codeempereor/XY-Vision-Picker/02_Hardware/05_实物照片/联调实拍/4a7bcef3391a2931d7f020fb1421db3a.jpg

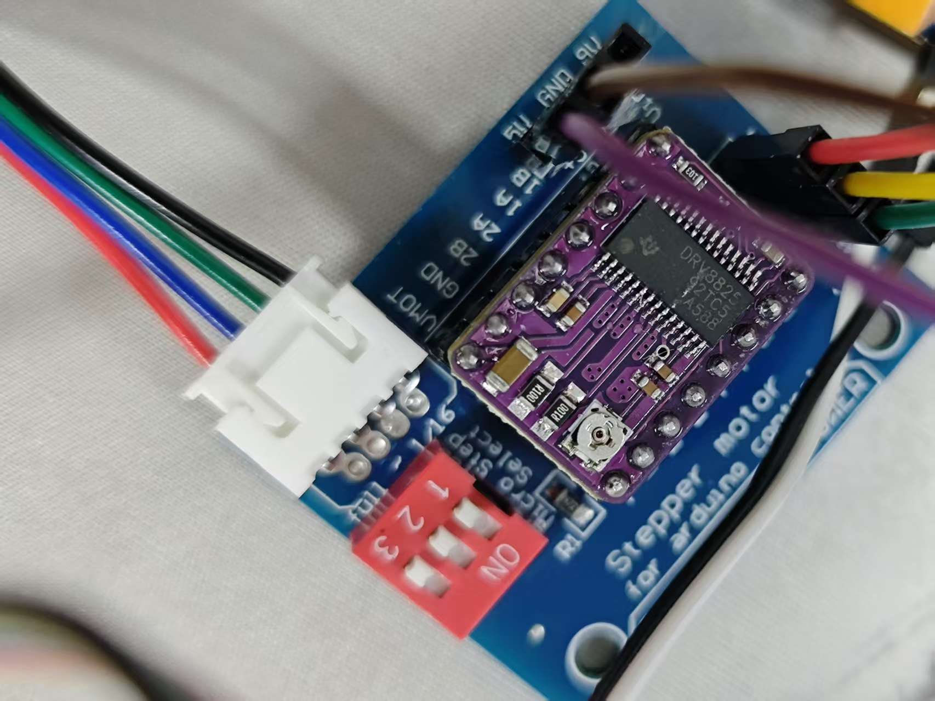
02_Hardware/05_实物照片/联调实拍/4a7bcef3391a2931d7f020fb1421db3a.jpg
