codeempereor/XY-Vision-Picker/02_Hardware/04_接线图/主板安装固定示例 (2).png

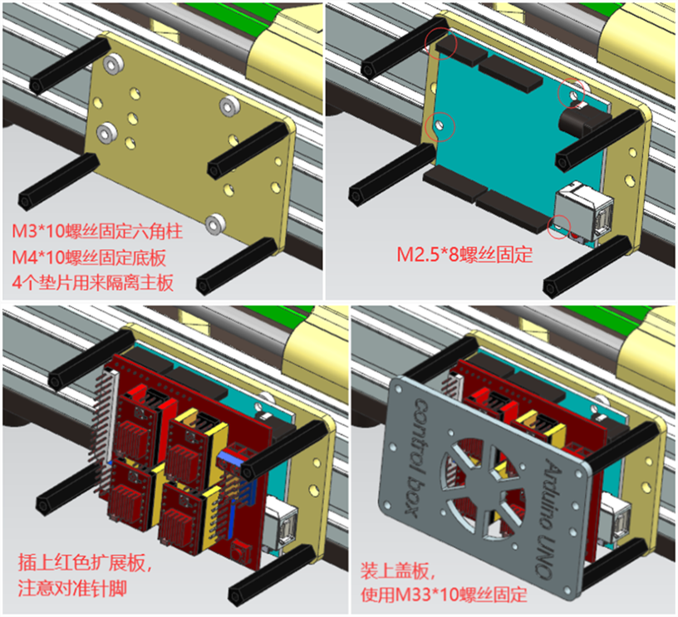
02_Hardware/04_接线图/主板安装固定示例 (2).png
