codeempereor/XY-Vision-Picker/02_Hardware/05_实物照片/README.md

# 实物照片

本项目硬件实物照片档案。

## 目录

| 位置 | 内容 |
|---|---|
| `滑台实物图_01~04.jpg` | CoreXY 滑台整机实拍 |
| `07_开发板实物与标注.bmp` | GEC-M4 开发板引脚标注图（原件来自 D 盘开发板资料包） |
| `08_JLink与开发板的连接.bmp` | J-Link 与开发板连接示意 |
| `联调实拍/` | 2026-10 联调期间实拍：板卡引脚标识、驱动板-电机接线、限位开关、电源模块、上位机界面等（哈希名原样保留） |

## 实物模块照片（按内容命名）

| 文件 | 实物 |
|---|---|
| `联调实拍/电源模块_24V开关电源.jpg` | 24V 开关电源模块（鳄鱼夹接线调试场景） |
| `联调实拍/步进电机_42电机与联轴器滑台.jpg` | 42 步进电机 + 联轴器 + 铝型材滑台 |
| `联调实拍/驱动板_HW434_A4988扩展板.jpg` | HW-434 扩展板 + A4988（含 Micro Step 拨码、电流电位器） |
| `联调实拍/ST-Link_V2调试器.jpg` | ST-LINK V2 下载调试器 |
| `联调实拍/USB转CAN适配器_UTC-T01.jpg` | USB 转 CAN 适配器（UTC-T01：CANH/CANL/GND + 120R 终端开关） |
