codeempereor/XY-Vision-Picker/01_Docs/03_参考文献/README.md

# 参考文献与参考资料索引

本项目引用/参考的第三方资料统一存放在 `06_Resources/`，本目录仅做索引，不重复存放原件。

## 资料分区

| 分区 | 内容 |
|---|---|
| `06_Resources/corexy XY滑台资料/` | CoreXY 滑台框架/安装/接线资料、42 步进电机、A4988 电流调节、安装视频（含 03.滑块安装、10.同步带同步轮安装 等） |
| `06_Resources/PCAN/` | USB 转 CAN 全套：上位机软件（pcanview/TSMaster/cangaroo）、驱动（win/linux）、二次开发 PCAN-Basic、原理图、固件烧录工具、USB 转 CAN 使用说明书 |
| `06_Resources/STM32F407ZET6/` | STM32F407 数据手册、F4 中文参考手册、Cortex-M4 内核编程手册、标准外设库手册、GEC-M4 原理图 |
| `06_Resources/YX64074-OV2640摄像头红版-190518/` | OV2640 摄像头模块原理图、参考资料、配套软件（串口摄像头调试） |

## 关键文档（按需查阅）

| 文档 | 位置 |
|---|---|
| STM32F4xx 中文参考手册 | `06_Resources/STM32F407ZET6/STM32F4xx中文参考手册.pdf` |
| GEC-M4 原理图 | `06_Resources/STM32F407ZET6/GEC-M4原理图2016-07-29.pdf` |
| USB 转 CAN 使用说明书 | `06_Resources/PCAN/USB转CAN使用说明书.pdf` |
| 滑台主板接线图 | `06_Resources/corexy XY滑台资料/步骤3.corexy主板安装接线图.doc` |

> 注：`01_Docs/02_开发文档/` 中的各模块开发文档亦引用了上述资料，正文中出现的事实以开发文档与实物为准。
