codeempereor/XY-Vision-Picker/06_Resources/corexy XY滑台资料/CH340G_USB转TTL驱动程序/README.txt

1. Install the program.
2. Copy Loader to the program directory - something like C:\Program Files\Simplify 3D 3.0.2\
3. Change the destkop shortcut to point to the loader. 
4. Happy printing! :)

I compiled the program with visual studio so you may need to download the Visual C++ redistributable. And yes it is because i'm lazy! :P

By the way, sometimes the Loader may be too slow and fail to initiate the program. In that case just execute it again. :)
Tested under windows 10
