codeempereor/XY-Vision-Picker/06_Resources/PCAN/驱动/linux/操作说明.txt

ubuntu系统上使用

(1) 需要确认安装好下面的相关库：

	# sudo apt-get install libpopt-dev
	# sudo apt install make
	# sudo apt install make-guile
	# sudo apt install gcc
	# sudo apt install g++
	# sudo apt install libpopt-dev

(2) 安装pcan驱动：

	# tar xvf peak-linux-driver-8.15.2.tar.gz
	# cd peak-linux-driver-8.15.2/
	# make clean
	# make
	# sudo make install 

	# pcaninfo		（接上板子之后，输入这个命令可以查看到pcan驱动和板子的信息）

boardcon@ubuntu20:~/opt/peak-linux-driver-8.15.2$ pcaninfo
PCAN driver version: 8.15.2
PCAN-Basic version: 4.6.2.36

  * pcanusb32: "PCAN_USBBUS1" (0x051), PCAN-USB #1, devid=0x00 (/sys/class/pcan/pcanusb32)

(3) 安装 pcanview:

	# wget -q http://www.peak-system.com/debian/dists/`lsb_release -cs`/peak-system.list -O- | sudo tee /etc/apt/sources.list.d/peak-system.list
	# wget -q http://www.peak-system.com/debian/dists/wheezy/peak-system.list -O- | sudo tee /etc/apt/sources.list.d/peak-system.list
	# wget -q http://www.peak-system.com/debian/peak-system-public-key.asc -O- | sudo apt-key add -
	# sudo apt-get update
	# sudo apt-get install pcanview-ncurses

	执行完上面的命令之后，pcanview 就安装成功了，可以查看到： 

	# ls /usr/bin/pcanview	

	# pcanview	(运行pcanview应用，设置好波特率后就可以收发数据了)

其他参考安装pcanview:	（测试未通过，安装完之后，执行 pcanview 命令提示没有这个目录或文件）

	#wget https://www.peak-system.com/debian/dists/trusty/non-free/binary-i386/pcanview-ncurses_0.8.9-0_i386.deb
	#sudo dpkg -i pcanview-ncurses_0.8.9-0_i386.deb

	#wget https://www.peak-system.com/debian/dists/trusty/non-free/binary-i386/pcanview-ncurses_0.9.2-0_i386.deb
	#sudo dpkg -i pcanview-ncurses_0.9.2-0_i386.deb
