codeempereor/XY-Vision-Picker/01_Docs/02_开发文档/01_视觉识别模块开发文档.docx

视觉识别模块开发文档

K210 + OV2640 颜色识别与坐标输出

XY_Vision_Picker 项目

版本：v1.0 ｜ 日期：2026-09-23 ｜ 状态：开发指导

1. 模块概述

1.1 职责

本模块负责采集工作台面图像，通过颜色分割识别目标色块，输出其像素质心坐标给 STM32 主控。本模块不做运动决策，只做视觉检测与坐标输出。

1.2 性能指标

表 1-1 视觉模块性能指标

指标 | 目标值
分辨率 | QVGA 320×240，RGB565
识别帧率 | ≥ 10 fps（周期 80 ms）
坐标输出 | 像素质心 (cx, cy)，单位像素
识别成功率 | 标准色块 ≥ 95%（实时光照下）
通信接口 | UART 115200-8-N-1
未识别输出 | $0,0,0\n

1.3 硬件清单

表 1-2 视觉模块硬件清单

# | 物料 | 型号/规格 | 数量 | 备注

1 | 视觉主控 | K210 开发板（Maix Bit） | 1 | Type-C 供电
2 | 摄像头模块 | 正点原子 ATK-OV2640 红版 V1.2 | 1 | 2×9 排针
3 | 连接线 | 杜邦线公对公 15 根 | 1 排 | 飞线用
4 | 限流电阻 | 1 kΩ 0805 或直插 | 8 个 | D0~D7 数据线各串一个
5 | 遮光罩 | 黑色卡纸或 3D 打印 | 1 | 固定在镜头周围

2. 硬件接线

2.1 OV2640 模块引脚定义

ATK-OV2640 模块为 2×9 排针（2.54 mm 间距），共 18 个引脚，其中 15 个有效。模块自带 12 MHz 有源晶振和 1.3V/2.8V LDO，外部仅需 3.3V 供电。

表 2-1 OV2640 模块引脚定义

引脚号 | 名称 | 方向 | 说明
1 | GND | — | 地线
2 | VCC3.3 | IN | 3.3V 电源
3 | OV_SCL | IN | SCCB 时钟（类 IIC）
4 | OV_VSYNC | OUT | 帧同步
5 | OV_SDA | IN/OUT | SCCB 数据
6 | OV_HREF | OUT | 行参考
7 | OV_D0 | OUT | 数据线 bit0
8 | OV_RESET | IN | 复位（低有效）
9~14 | OV_D1~D6 | OUT | 数据线 bit1~bit6
15 | OV_PCLK | OUT | 像素时钟
16 | OV_D7 | OUT | 数据线 bit7
17 | OV_PWDN | IN | 掉电使能（高有效）
18 | NC | — | 不接

2.2 K210 飞线对照表

K210 开发板（Maix Bit）的 DVP 摄像头接口与 OV2640 模块引脚对照如下。D0~D7 数据线各串 1 kΩ 电阻限流，其余直连。

表 2-2 OV2640 ↔ K210 飞线对照表

OV2640 引脚 | K210 引脚 | 备注
GND | GND | 共地
VCC3.3 | 3.3V | 模块供电
OV_SCL (SIO_C) | IO_SCL (GPIOS)
OV_SDA (SIO_D) | IO_SDA (GPIOS)
OV_VSYNC | IO7
OV_HREF | IO6
OV_PCLK | IO5
OV_D0 | IO8 | 串 1 kΩ
OV_D1 | IO9 | 串 1 kΩ
OV_D2 | IO10 | 串 1 kΩ
OV_D3 | IO11 | 串 1 kΩ
OV_D4 | IO12 | 串 1 kΩ
OV_D5 | IO13 | 串 1 kΩ
OV_D6 | IO14 | 串 1 kΩ
OV_D7 | IO15 | 串 1 kΩ
OV_RESET | 直连 GND（不复位）或 IO 控制
OV_PWDN | 直连 GND（不进掉电）

注意：以上引脚为 Maix Bit 标准 DVP 接口定义，实际以所用 K210 开发板丝印为准。若使用其他 K210 板型，需查该板型的摄像头引脚映射。

3. 开发环境搭建

3.1 软件安装

- 安装 MaixPy IDE（官网下载 Windows 版），用于在线编程和调试；
- K210 开发板用 Type-C 线连 PC，设备管理器看到串口（CH340 或类似）；
- MaixPy IDE 左下角选对应串口，波特率 115200；
- 点连接，运行 `print("hello")` 确认环境通。

3.2 出图验证

连接好 OV2640 后，先运行最小出图代码：

import sensor, time
sensor.reset()
sensor.set_pixformat(sensor.RGB565)
sensor.set_framesize(sensor.QVGA)
sensor.run(1)
while True:
img = sensor.snapshot()
time.sleep_ms(50)

MaixPy IDE 应实时显示摄像头画面。若黑屏：检查排线/飞线方向、3.3V 供电是否接对、PWDN 是否拉低。

4. 软件设计

4.1 主程序结构

import sensor, image, time, gc
from machine import UART

# 初始化串口
uart = UART(UART.UART1, 115200, timeout=1000)

# 初始化摄像头
sensor.reset()
sensor.set_pixformat(sensor.RGB565)
sensor.set_framesize(sensor.QVGA) # 320x240
sensor.run(1)

# LAB 颜色阈值（标定后替换）
RED = (30, 80, 30, 80, -20, 20)

while True:
img = sensor.snapshot()
blobs = img.find_blobs([RED],
pixels_threshold=200,
area_threshold=200,
merge=True)
if blobs:
b = max(blobs, key=lambda x: x.pixels())
cx, cy = b.cx(), b.cy()
uart.write("$%d,%d,1\n" % (cx, cy))
else:
uart.write("$0,0,0\n")
gc.collect()
time.sleep_ms(80)

4.2 阈值标定

LAB 阈值必须在实际工作光照下标定，不能直接用默认值。标定方法：

- 把目标色块放在工作台上，用最终装配的光源照射；
- MaixPy IDE 运行 `img.binary([THRESHOLD])` 观察二值化结果；
- 拖动 L/A/B 上下界滑块，直到目标块完整保留、背景全部变黑；
- 记录三组上下界 (L_min, L_max, A_min, A_max, B_min, B_max)，写入代码；
- 标定后加半透明遮光罩，避免环境光变化导致阈值漂移；
- 多颜色目标时，定义多组阈值数组，由 STM32 通过 color_id 选择。

4.3 串口协议

表 4-1 视觉串口协议

方向 | 格式 | 说明
K210→STM32 | $cx,cy,flag\n | 例：$128,96,1\n（识别到目标）
K210→STM32 | $0,0,0\n | 未识别到目标
STM32→K210 | @STATUS\n | 0=可识别，1=运动中忽略，2=完成

STM32 在运动中回复 @1，K210 收到后仍持续发坐标但 STM32 忽略；抓取完成后 STM32 回复 @2，K210 进入下一周期检测。

5. 开发步骤

表 5-1 视觉模块开发步骤

步骤 | 内容 | 验收标准
1 | 飞线连接 OV2640 到 K210 | MaixPy IDE 能出图，无花屏
2 | 固定摄像头安装位置 | 镜头正对工作台，画面覆盖整个工作区
3 | 实际光照下标定 LAB 阈值 | 目标块二值化完整，背景无残留
4 | 写主循环 find_blobs + 串口发送 | 串口助手看到 $cx,cy,1 实时跟随
5 | 未识别测试：移走色块 | 串口发 $0,0,0\n
6 | 80ms 周期稳定性测试 | 连续 5 分钟无丢帧、无乱码
7 | 加遮光罩，复测阈值 | 不同时间段光照下识别率稳定

6. 调试方法

6.1 常见问题

表 6-1 视觉模块常见问题

现象 | 排查方向
黑屏无图像 | PWDN 拉高？RESET 拉高？3.3V 供电？飞线接反？
花屏/颜色异常 | PCLK 极性？D0~D7 接错位？数据线串电阻过大？
识别时有时无 | 光照变化？阈值太窄？加遮光罩重新标定
串口乱码 | 波特率不一致？TX/RX 接反？未共地？
坐标跳动大 | blob 噪声多？pixels_threshold 调高？merge=True？

6.2 调试工具

- 串口助手：XCOM 或 PuTTY，115200 8-N-1，看 $ 帧格式；
- MaixPy IDE 阈值编辑器：实时调阈值；
- 在代码里加 `img.draw_rectangle(b.rect())` 画框，IDE 里看识别位置。

7. 验收标准

- MaixPy IDE 实时出图，画面清晰；
- 目标色块在工作区任意位置，串口 80ms 内输出正确质心坐标；
- 移走色块，500ms 内输出 $0,0,0；
- 连续运行 30 分钟无死机、无丢帧；
- 实时光照下识别成功率 ≥ 95%。

8. 风险与注意事项

表 8-1 视觉模块风险清单

风险 | 后果 | 对策
飞线接触不良 | 图像闪烁或无图 | 杜邦线插紧，必要时焊接
未加遮光罩 | 阈值随光照漂移 | 必须加遮光罩，固定标定
D0~D7 未串电阻 | 长期可能损 K210 IO | 按设计串 1 kΩ
摄像头安装倾斜 | 仿射标定误差大 | 镜头垂直工作台，用水平尺校准
未识别时未发 $0,0,0 | STM32 卡在旧坐标 | 主循环必须每次都发帧
