codeempereor/XY-Vision-Picker/01_Docs/02_开发文档/02_运动控制模块开发文档.docx

运动控制模块开发文档

STM32 + CoreXY + DRV8825 + MG90S

XY_Vision_Picker 项目

版本：v1.0 ｜ 日期：2026-09-23 ｜ 状态：开发指导

1. 模块概述

1.1 职责

本模块是系统核心，负责接收视觉坐标，完成像素→毫米换算、运动规划、步进脉冲输出、夹爪控制，并通过 CAN 上报状态。同时支持本地 TFT 屏 + 键盘离线操作。

1.2 性能指标

表 1-1 运动模块性能指标

指标 | 目标值
定位精度 | ≤ ±1 mm
最大速度 | 100 mm/s（可参数化）
加减速时间 | 200 ms（S 形）
单轴行程 | X: 200 mm，Y: 150 mm
脉冲当量 | 0.05 mm/脉冲（1/16 细分）
限位响应 | 硬件立即停脉冲，< 1 ms
CAN 上报周期 | 心跳 1 Hz，位置 20 Hz

2. 硬件设计

2.1 电源分配

表 2-1 电源分配表

电源 | 电压 | 负载 | 说明
主电源 | 24V/5A | DRV8825 电机供电 | 滑台电机
舵机电源 | 5V/2A | MG90S 夹爪 | 独立供电，禁止从板载 5V 取
逻辑电源 | 3.3V | STM32、TFT、键盘 | 板载 LDO
CAN 收发器 | 5V | TJA1050 | 与逻辑地共地

关键约束：MG90S 必须独立 5V 供电。舵机堵转瞬间电流可达 1A 以上，从 STM32 板载 5V 取电会拉低电压导致 MCU 复位。

2.2 STM32 引脚分配

表 2-2 STM32F407 引脚分配表

功能 | 引脚 | 外设/说明
X 轴 STEP | PA0 | TIM2_CH1 脉冲输出
X 轴 DIR | PB0 | GPIO 推挽
Y 轴 STEP | PA1 | TIM3_CH1 脉冲输出
Y 轴 DIR | PB1 | GPIO 推挽
舵机 PWM | PA8 | TIM1_CH1，50 Hz
K210 UART_RX | PA10 | USART1_RX
K210 UART_TX | PA9 | USART1_TX
TFT SPI SCK | PA5 | SPI1_SCK
TFT SPI MOSI | PA7 | SPI1_MOSI
TFT CS/DC/RST/BL | PB10/PB11/PB12/PB13 | GPIO
矩阵键盘 R1~R4 | PC0~PC3 | GPIO 输出
矩阵键盘 C1~C4 | PC4~PC7 | GPIO 上拉输入
CAN_RX / CAN_TX | PA11 / PA12 | CAN1 不重映射
限位 X+/X-/Y+/Y- | PB14/PB15/PB16/PB17 | 下拉输入
用户 LED | PC13 | 心跳指示，低电平点亮

2.3 DRV8825 驱动配置

- 细分：MS1/MS2/MS3 全部接 GND → 1/16 细分；
- Vref 计算：Vref = Imax × 0.5（DRV8825 公式）。42 电机额定 1.2A → Vref = 0.6V；
- 调 Vref：上电前先测电机线圈电阻，串万用表测电流，调电位器到目标电流；
- ENABLE：接 GPIO 或直接拉低使能，上电时默认失能避免误动；
- 散热：DRV8825 发热较大，必须贴散热片。

2.4 限位与急停

- 4 个限位开关（X+/X-/Y+/Y-）接 GPIO 下拉输入，触发为高电平；
- 限位中断优先级最高，触发立即关闭定时器脉冲输出；
- 限位触发后通过 CAN 0x301 上报，TFT 显示错误码，需上位机或键盘复位才能继续。

3. CubeMX 配置

3.1 时钟树

- HSE 8MHz 外部晶振 → PLL 倍频 → SYSCLK 168 MHz；
- APB1 定时器时钟 84 MHz，APB1 外设时钟 42 MHz（CAN 用此）；
- APB2 定时器时钟 168 MHz。

3.2 外设配置清单

表 3-1 CubeMX 外设配置

外设 | 参数 | 用途
TIM2 | CH1 PWM，分频 84-1，ARR 动态 | X 轴 STEP 脉冲
TIM3 | CH1 PWM，分频 84-1，ARR 动态 | Y 轴 STEP 脉冲
TIM1 | CH1 PWM，1MHz 计数，ARR=20000 | 舵机 50 Hz
USART1 | 115200 8-N-1，收发中断 | K210 通信
CAN1 | 500 kbps，列表 0 屏蔽位 | 上位机通信
SPI1 | 全双工主，10.5 MHz | TFT 屏
GPIO | PC0~PC7 键盘，PB14~PB17 限位 | 输入输出
FMC/FSMC | 未用

3.3 FreeRTOS 配置

- 系统时钟基准：SysTick 1 kHz；
- 堆大小：128 字；
- 任务数：5 个（见第 4 章）；
- 队列：坐标队列（深度 4）、命令队列（深度 4）；
- 优先级：运动任务 5（最高），通信 4，键盘 3，显示 2，心跳 1。

4. 软件架构

4.1 任务划分

表 4-1 FreeRTOS 任务划分

任务 | 优先级 | 周期/触发 | 栈大小 | 职责
vCommTask | 4 | 事件驱动 | 1024 | UART 收 K210 帧、CAN 收发
vMotionTask | 5 | 事件驱动 | 512 | 坐标→插补→脉冲→舵机
vDisplayTask | 2 | 50 ms | 512 | 刷新 TFT
vKeyTask | 3 | 20 ms | 256 | 矩阵键盘扫描
vHeartbeatTask | 1 | 1 s | 256 | LED 闪烁 + CAN 心跳

4.2 状态机

运动任务内部维护状态机，避免命令竞争：

STATE_IDLE = 0 # 空闲
STATE_HOME = 1 # 回零
STATE_MANUAL = 2 # 手动
STATE_AUTO = 3 # 自动抓取
STATE_GRIPPING = 4 # 抓取中
STATE_DONE = 5 # 完成

状态切换由命令帧（0x201）或事件（到位/限位/错误）触发。运动中收到新坐标入队，当前运动完成后再处理。

5. 运动学算法

5.1 CoreXY 解算

CoreXY 平台两电机转角与滑台位置耦合。设两电机脉冲增量为 dm1、dm2：

dx = (dm1 + dm2) / 2 # 滑台 X 方向脉冲增量
dy = (dm1 - dm2) / 2 # 滑台 Y 方向脉冲增量
dm1 = dx + dy # 电机1脉冲
dm2 = dx - dy # 电机2脉冲

方向判定：上位机或键盘发目标 (tx, ty)，先算位移 (dx_mm, dy_mm)，乘脉冲当量得到脉冲数 (px, py)，再反解为两电机脉冲，分别输出。

5.2 脉冲当量计算

以 GT2 同步带（齿距 2mm）、16 齿同步轮为例：每圈 32mm，1/16 细分下每圈 3200 脉冲，脉冲当量 = 32/3200 = 0.01 mm/脉冲。实际值需实测：手动走 100mm 记录脉冲数，反算脉冲/mm。

5.3 S 形加减速

- 起步段：200ms 内从 0 加速到目标速度，线性插值；
- 匀速段：按目标速度运行；
- 停止段：200ms 内减速到 0；
- 实现方式：定时器 ARR 动态修改，频率随速度变化；
- 低速运行（< 20mm/s）可省略加减速，直接以低速启动。

5.4 直线插补

采用 Bresenham 逐点比较法：以位移较长的轴为主轴，每发一个主轴脉冲，副轴按误差累积决定是否补脉冲。保证两轴同时到位。

6. 视觉-运动学标定

6.1 标定流程

- 滑台回机械零位（X-、Y- 限位触发点）；
- 工作台面放置打印网格标记点（如 (20,20)、(60,60)、(100,100)、(140,100)、(180,20)，单位 mm）；
- 手动移动滑台到每个标记点上方，K210 读取该点像素坐标；
- 最小二乘拟合仿射变换系数 (a,b,c,d,e,f)；
- 系数存入 STM32 内部 Flash 保留扇区（0x0800 FC00）；
- 用 3 个未参与拟合的点验证，误差 ≤ ±1 mm。

6.2 仿射变换模型

mm_x = a * px + b * py + c
mm_y = d * px + e * py + f

采用仿射而非简单比例，补偿摄像头非垂直安装带来的平移、旋转、缩放与切变误差。

6.3 Flash 存储

- 地址：0x0800 FC00（F407 最后一页，2KB）；
- 结构：魔数 0xCA11AB1E + 6 个 float 系数 + CRC；
- 上电读 Flash，魔数不对则用默认值 (1,0,0,0,1,0)，提示重新标定。

7. 开发步骤

表 7-1 运动模块开发步骤

步骤 | 内容 | 验收标准
1 | 单轴点动：X 轴发脉冲走 100mm | 平稳无异响，记录脉冲/mm
2 | Y 轴同上 | 方向正确
3 | CoreXY 解算：双轴走矩形 | 5 圈无丢步、无累计偏差
4 | S 形加减速 | 高速起步不丢步
5 | 舵机 50Hz PWM | 0/90/180° 到位不抖
6 | 4 个限位触发 | 立即停脉冲，发错误码
7 | TFT 显示 + 键盘扫描 | 坐标/状态/计数正确
8 | UART 收 K210 坐标 | TFT 显示毫米坐标
9 | 仿射标定 | 3 验证点误差 ≤ ±1mm
10 | 整链抓取 | 连续 20 次成功率 ≥ 90%

8. 调试方法

8.1 常见问题

表 8-1 运动模块常见问题

现象 | 排查方向
电机不转 | DIR/STEP 接线？Vref 太低？ENABLE 拉高？
丢步 | 速度太快？加减速时间太短？Vref 不足？
方向反 | 电机线反转 180° 或改 DIR 逻辑
XY 颠倒 | CoreXY 解算 dm1/dm2 接反
MCU 复位 | 舵机从板载取电？独立 5V 接了吗？
限位误触发 | 上拉/下拉接反？开关型号？

9. 验收标准

- 单轴手动走 100mm，重复定位误差 ≤ ±0.5mm；
- 矩形轨迹 5 圈无累计偏差；
- 4 个限位触发立即停，无误触发；
- 舵机夹爪开合到位，不抖动；
- 仿射标定误差 ≤ ±1mm；
- 自动抓取连续 20 次成功率 ≥ 90%；
- 连续运行 30 分钟无死机、无丢步、无异常温升。

10. 风险与注意事项

表 10-1 运动模块风险清单

风险 | 后果 | 对策
MG90S 板载取电 | MCU 复位 | 独立 5V 供电
DRV8825 Vref 过高 | 烧电机 | 按 Imax×0.5 计算，串电流表调
未加散热片 | 驱动过热保护 | 必须贴散热片
高速无加减速 | 丢步 | S 形加减速 200ms
限位时序错 | 撞机械 | 上电先测限位逻辑
24V 带电插拔 | 烧驱动 | 断电接线
