codeempereor/XY-Vision-Picker/01_Docs/02_开发文档/03_上位机模块开发文档.docx

上位机模块开发文档

Qt Widgets + QCanBus (peakcan)

XY_Vision_Picker 项目

版本：v1.0 ｜ 日期：2026-09-23 ｜ 状态：开发指导

1. 模块概述

1.1 职责

上位机运行在 PC 上，通过 PEAK 兼容 USB-CAN 适配器与 STM32 通信，负责设备状态监控、运动轨迹绘制、命令下发、参数设置和日志记录。上位机不参与实时闭环，断开不影响 STM32 本地运行。

1.2 性能指标

表 1-1 上位机性能指标

指标 | 目标值
CAN 波特率 | 500 kbps
状态刷新 | 20 Hz（位置帧）
轨迹绘制 | 实时滚动，延迟 < 100ms
命令响应 | 按钮到 STM32 执行 < 50ms
日志格式 | CSV，时间戳+坐标+结果
平台 | Windows 10/11 64位

2. 开发环境

2.1 软件安装

表 2-1 开发环境

软件 | 版本 | 用途
Qt Creator | 5.15 LTS MinGW 64 | IDE
Qt 模块 | SerialBus, Widgets | CAN + UI
QCustomPlot | 2.x | 实时轨迹绘图
PEAK 驱动 | PeakOemDrv.exe | PCAN 适配器驱动
编译器 | MinGW 7.3 64bit | Qt 自带

2.2 工程配置

pro 文件关键配置：

QT += core gui widgets serialbus

SOURCES += main.cpp \
mainwindow.cpp \
candevice.cpp
HEADERS += mainwindow.h \
candevice.h

# QCustomPlot
INCLUDEPATH += $$PWD/qcustomplot
SOURCES += $$PWD/qcustomplot/qcustomplot.cpp
HEADERS += $$PWD/qcustomplot/qcustomplot.h

2.3 PEAK 驱动安装

- 解压 PEAK-System_Driver-Setup.zip，运行 PeakOemDrv.exe；
- 插 PCAN 适配器，设备管理器看到 PEAK USB CAN；
- 拨码开关拨到 120R（启用终端电阻）；
- 用 PcanView.exe 验证：选 500kbps，Connect，能看到设备在线。

3. CAN 通信设计

3.1 QCanBus 初始化

#include <QCanBus>
#include <QCanBusDevice>

QCanBusDevice *dev = QCanBus::instance()
->createDevice("peakcan", "usb0", nullptr);
if (!dev) { qDebug() << "createDevice failed"; }

dev->setConfigurationParameter(QCanBusDevice::BitRateKey, 500000);
if (!dev->connectDevice()) { qDebug() << "connect failed"; }

connect(dev, &QCanBusDevice::framesReceived,
this, &MainWindow::onFramesReceived);

3.2 收帧解析

收到帧后按帧 ID 分发：

void MainWindow::onFramesReceived() {
while (dev->framesAvailable()) {
QCanBusFrame frame = dev->readFrame();
switch (frame.frameId()) {
case 0x101: parseHeartbeat(frame.payload()); break;
case 0x102: parsePosition(frame.payload()); break;
case 0x301: parseError(frame.payload()); break;
case 0x302: parseDone(frame.payload()); break;
}
}
}

3.3 发帧

命令帧组包发送：

void MainWindow::sendCommand(quint8 cmd, qint16 px, qint16 py, quint8 speed) {
QByteArray payload(8, 0);
payload[0] = cmd;
qToLittleEndian(px, (uchar*)&payload[1]);
qToLittleEndian(py, (uchar*)&payload[3]);
payload[5] = speed;
dev->writeFrame(QCanBusFrame(0x201, payload));
}

3.4 帧 ID 汇总

表 3-1 上位机帧处理

ID | 方向 | 名称 | 上位机处理
0x101 | 收 | 状态心跳 | 刷新状态栏
0x102 | 收 | 位置上报 | 更新轨迹图
0x201 | 发 | 命令帧 | 按钮触发
0x202 | 发 | 参数设置 | 对话框确认
0x301 | 收 | 错误告警 | 弹窗 + 日志
0x302 | 收 | 抓取完成 | 记录日志

4. 界面设计

4.1 窗口布局

- 顶部：CAN 连接栏（设备选择、波特率、Connect/Disconnect 按钮）；
- 左侧：状态栏（当前 X/Y、运行状态、抓取计数、错误码）；
- 中部：QCustomPlot 轨迹图（实时绘制 XY 运动轨迹）；
- 右侧：命令按钮组（回零、自动抓取、停止、夹爪开/关）；
- 底部：参数设置区（目标颜色、速度百分比、投放点 X/Y）；
- 日志面板：下方文本框，显示事件和错误。

4.2 控件清单

表 4-1 界面控件清单

控件 | 类型 | 用途
btnConnect | QPushButton | 连接/断开 CAN
lblPos | QLabel | 当前 X/Y 坐标
lblState | QLabel | 运行状态
lblCount | QLabel | 抓取计数
plotTraj | QCustomPlot | 实时轨迹
btnHome | QPushButton | 回零命令 0x01
btnAuto | QPushButton | 自动抓取 0x03
btnStop | QPushButton | 停止 0x04
btnGripClose | QPushButton | 夹爪闭 0x05
btnGripOpen | QPushButton | 夹爪开 0x06
spdSpeed | QSpinBox | 速度 0~100%
cmbColor | QComboBox | 目标颜色
txtLog | QPlainTextEdit | 事件日志

5. 开发步骤

表 5-1 上位机开发步骤

步骤 | 内容 | 验收标准
1 | 装 Qt + PEAK 驱动 | PcanView 能连上适配器
2 | 建 Qt Widgets 工程 | 空窗口编译通过
3 | 集成 QCustomPlot | 画静态正弦曲线
4 | QCanBus 连接 usb0 | connectDevice 成功
5 | 收 0x101 心跳 | 状态栏坐标每秒更新
6 | 收 0x102 位置 | 轨迹图实时绘制
7 | 发 0x201 命令 | STM32 响应动作
8 | 错误弹窗 | 0x301 收到即弹窗
9 | 日志写 CSV | 关闭后重开文件存在

6. 调试方法

6.1 常见问题

表 6-1 上位机常见问题

现象 | 排查方向
createDevice 失败 | PEAK 驱动装了吗？设备插了吗？
connectDevice 失败 | 波特率不对？设备被占用？
收不到帧 | STM32 在发吗？过滤器配置？
坐标乱跳 | 大小端？0.1mm 单位？
轨迹图卡顿 | 刷新频率太高？降采样？

6.2 调试工具

- PcanView.exe：先于 Qt 程序抓包，确认 STM32 帧格式正确；
- qDebug()：打印帧 ID 和 payload 十六进制；
- Qt 自带 CAN 总线分析工具（Qt CAN Bus Analyzer）。

7. 验收标准

- 一键连接 PCAN 适配器，状态栏显示已连接；
- 0x101 心跳收到后坐标/状态/计数正确显示；
- 0x102 位置帧驱动轨迹图实时绘制；
- 按钮下发命令，STM32 100ms 内响应；
- 0x301 错误弹窗，0x302 完成记录日志；
- 日志 CSV 文件可用 Excel 打开。

8. 风险与注意事项

表 8-1 上位机风险清单

风险 | 后果 | 对策
PEAK 驱动未装 | createDevice 失败 | 先装 PeakOemDrv.exe
终端电阻未拨 | CAN 通信不稳 | PCAN 拨码拨到 120R
大小端搞反 | 坐标错误 | 统一小端，qToLittleEndian
界面卡顿阻塞 CAN | 丢帧 | 收帧放子线程或信号槽异步
未释放设备 | 下次连接失败 | 退出时 disconnectDevice
