codeempereor/XY-Vision-Picker/01_Docs/02_开发文档/04_通信通道开发文档.docx

通信通道开发文档

UART (K210↔STM32) + CAN (STM32↔PC)

XY_Vision_Picker 项目

版本：v1.0 ｜ 日期：2026-09-23 ｜ 状态：开发指导

1. 通信总览

系统包含两条独立通信链路：

- 链路 A：K210 ↔ STM32，UART 串口，传输视觉坐标；
- 链路 B：STM32 ↔ PC，CAN 总线，传输状态、命令、错误。

两条链路相互独立，K210 不直接连 PC。所有上位机命令都经 STM32 中转执行。

2. 链路 A：K210 ↔ STM32（UART）

2.1 物理层参数

表 2-1 UART 物理层参数

参数 | 取值
物理接口 | UART，交叉连接（K210_TX → STM32_RX）
STM32 外设 | USART1
STM32 引脚 | PA9=TX，PA10=RX
波特率 | 115200 bps
数据位 | 8
校验 | 无
停止位 | 1
流控 | 无
电气 | 双方必须共地
电平 | 3.3V TTL，不可直连 RS232

2.2 协议帧格式

采用文本帧，以换行符 \n 结尾，可读性好，便于串口助手调试。

表 2-2 UART 协议帧格式

方向 | 格式 | 示例 | 含义
K210→STM32 | $cx,cy,flag\n | $128,96,1\n | 识别到目标，质心 (128,96)
K210→STM32 | $0,0,0\n | $0,0,0\n | 未识别到目标
STM32→K210 | @STATUS\n | @1\n | 运动中，忽略新坐标
STM32→K210 | @STATUS\n | @0\n | 空闲，可识别新目标
STM32→K210 | @STATUS\n | @2\n | 抓取完成

2.3 时序要求

- K210 发送周期：80 ms（12.5 fps）；
- STM32 接收超时：500 ms 未收到帧则置 K210 超时错误；
- STM32 回复延迟：收到坐标后 10ms 内回 @STATUS。

2.4 STM32 接收代码

#define UART_BUF_SIZE 64
char rx_buf[UART_BUF_SIZE];
volatile int rx_idx = 0;

void USART1_IRQHandler(void) {
if (USART1->SR & USART_SR_RXNE) {
char c = USART1->DR;
if (c == '\n' || rx_idx >= UART_BUF_SIZE-1) {
rx_buf[rx_idx] = 0;
parse_vision_frame(rx_buf);
rx_idx = 0;
} else if (c != '\r') {
rx_buf[rx_idx++] = c;
}
}
}

void parse_vision_frame(char *s) {
if (s[0] != '$') return;
int cx, cy, flag;
sscanf(s+1, "%d,%d,%d", &cx, &cy, &flag);
// 入队给运动任务
VisionPoint vp = {cx, cy, flag, xTaskGetTickCount()};
xQueueSend(vx_queue, &vp, 0);
}

2.5 联调步骤

表 2-3 UART 联调步骤

步骤 | 操作 | 验收
1 | USB-TTL 分别连 K210 和 STM32 的 TX/RX | 串口助手能看到 $ 帧
2 | K210 发，STM32 不接 | 串口助手收到 $128,96,1
3 | STM32 回 @0 | K210 串口助手收到 @0
4 | 共地后对接 | TFT 显示收到的毫米坐标
5 | 断 K210 | STM32 500ms 后报超时错误

3. 链路 B：STM32 ↔ PC（CAN）

3.1 物理层

表 3-1 CAN 物理层参数

参数 | 取值
CAN 控制器 | STM32F407 内置 bxCAN1
引脚 | PA11=CAN_RX，PA12=CAN_TX
收发器 | TJA1050，5V 供电
线缆 | 双绞线 CAN_H / CAN_L
终端电阻 | PCAN 适配器拨 120R，STM32 侧不焊
节点数 | 2 个（STM32 + PC）
帧格式 | CAN 2.0B 标准帧 11-bit ID

3.2 位时序

APB1 时钟 42 MHz，配置为 500 kbps：

表 3-2 CAN 位时序

参数 | 取值 | 说明
Prescaler | 6 | tq = 42/6 = 7 MHz
BS1 | 10 tq | 段 1
BS2 | 3 tq | 段 2
SJW | 1 tq | 同步跳转宽度
每比特 | 14 tq | 1+10+3
位速率 | 500 kbps | 7 MHz / 14
采样点 | 78.6% | (1+10)/14，推荐区间 75~87.5%

3.3 帧 ID 分配

表 3-3 CAN 帧 ID 分配

ID | 方向 | 名称 | 频率 | 说明
0x101 | STM32→PC | 状态心跳 | 1 Hz | 位置+状态+计数+错误
0x102 | STM32→PC | 运动位置 | 20 Hz | 当前+目标位置
0x201 | PC→STM32 | 命令 | 事件 | 回零/移动/自动/停止/夹爪
0x202 | PC→STM32 | 参数 | 事件 | 颜色/速度/投放点
0x301 | STM32→PC | 错误告警 | 事件 | 错误位+出错位置
0x302 | STM32→PC | 抓取完成 | 事件 | 结果+目标+实际

3.4 数据域定义（8 字节小端序）

0x101 状态心跳

偏移 | 类型 | 含义
0-1 | int16 | pos_x（0.1mm）
2-3 | int16 | pos_y（0.1mm）
4 | uint8 | state：0空闲 1回零 2手动 3自动 4抓取中 5完成
5 | uint8 | error_code
6 | uint8 | grip_count
7 | uint8 | 保留

0x102 运动位置

偏移 | 类型 | 含义
0-1 | int16 | 当前 X（0.1mm）
2-3 | int16 | 当前 Y（0.1mm）
4-5 | int16 | 目标 X（0.1mm）
6-7 | int16 | 目标 Y（0.1mm）

0x201 命令帧

偏移 | 类型 | 含义
0 | uint8 | cmd：0x01回零 0x02移动 0x03自动 0x04停止 0x05夹爪闭 0x06夹爪开
1-2 | int16 | param1：cmd=0x02 时目标 X
3-4 | int16 | param2：cmd=0x02 时目标 Y
5 | uint8 | speed：0~100
6-7 | uint8 | 保留

3.5 过滤器配置

- 过滤器组 0，32 位屏蔽位模式；
- 只放行 0x201 和 0x202 两个下行帧；
- FIFO0 接收，溢出即置错误；
- 中断：FIFO0 挂帧中断、溢出中断、错误中断、Bus-off 中断。

3.6 STM32 发送代码

void can_send(uint16_t id, uint8_t *data, uint8_t len) {
CanTxMsgTypeDef msg;
msg.StdId = id;
msg.IDE = CAN_ID_STD;
msg.RTR = CAN_RTR_DATA;
msg.DLC = len;
for (int i = 0; i < len; i++) msg.Data[i] = data[i];
while (CAN_Transmit(CAN1, &msg) == CAN_TxStatus_Failed);
}

void send_heartbeat(void) {
uint8_t buf[8];
to_little_int16(buf+0, pos_x * 10);
to_little_int16(buf+2, pos_y * 10);
buf[4] = state;
buf[5] = error_code;
buf[6] = grip_count;
buf[7] = 0;
can_send(0x101, buf, 8);
}

3.7 错误处理

- Bus-off：延时 100ms 软件复位 bxCAN，重发未完成帧；
- 发送失败：硬件自动重传，软件维护 4 帧环形缓冲；
- 上位机断连：不影响本地运行，重连后从 0x101 心跳恢复状态。

4. 联调流程

表 4-1 CAN 联调步骤

步骤 | 操作 | 验收
1 | PcanView 发 0x201 命令 | STM32 收到 LED 指示
2 | STM32 发 0x101 心跳 | PcanView 看到 1Hz 帧
3 | Qt 程序连接 | 状态栏显示坐标
4 | Qt 发自动命令 | STM32 启动抓取流程
5 | 拔 CAN 线 | STM32 本地仍可运行
6 | 插回 | Qt 自动恢复状态显示

5. 验收标准

5.1 UART

- K210 发 $ 帧，STM32 稳定解析，无乱码；
- 断 K210 后 500ms 内 STM32 报超时错误；
- 连续 30 分钟无丢帧。

5.2 CAN

- 500kbps 通信稳定，无错误帧；
- 0x101 心跳 1Hz，0x102 位置 20Hz；
- 0x201 命令 100ms 内响应；
- 拔插 CAN 线可自恢复；
- 总线负载率 < 30%。

6. 风险与注意事项

表 6-1 通信风险清单

风险 | 后果 | 对策
K210 与 STM32 未共地 | UART 乱码 | 必须共地
电机线与 CAN 线平行 | CAN 受干扰 | 分开走线，用双绞线
终端电阻缺失 | CAN 不稳 | PCAN 拨 120R
大小端不统一 | 坐标错误 | 统一小端
CAN 中断优先级太低 | 丢帧 | CAN 中断优先级高于普通
Bus-off 未恢复 | 总线挂死 | 软件自动复位
