codeempereor/XY-Vision-Picker/03_Firmware/PC_HMI/qcustomplot/README.md

# QCustomPlot

QCustomPlot 绘图库目录（预留）。

当前上位机界面使用自绘点阵视图（`dotmatrixview`，见 mypro00001 源码）显示坐标轨迹；如需引入 QCustomPlot 做曲线/轨迹图，将库文件（qcustomplot.h/.cpp）放入本目录并在 .pro 中引用。
