codeempereor/XY-Vision-Picker/03_Firmware/PC_HMI/src/README.md

# src 源码区

本目录为上位机源码归档区。当前工程完整源码位于 `../mypro00001/`（Qt 工程，含 .pro 与全部 .cpp/.h），打开工程请使用该目录；本目录预留用于后续源码整理或拆分。
