codeempereor/XY-Vision-Picker/06_Resources/YX64074-OV2640摄像头红版-190518/2，程序源码/readme.txt

该文件夹下包含4个源码：
（寄存器版本，适合探索者STM32F4开发板）实验42 照相机实验.rar
（库函数版本，适合探索者STM32F4开发板）实验42 照相机实验.rar

（寄存器版本，适合战舰V3和精英STM32开发板）扩展实验6 ATK-OV2640 摄像头模块测试实验.rar
（库函数版本，适合战舰V3和精英STM32开发板）扩展实验6 ATK-OV2640 摄像头模块测试实验.rar 

包含多款开发板的例程，每个例程又分为寄存器和库函数两个版本,请大家务必根据自己的开发板，下载正确的例程！不要下载错了。

例程使用说明请看源码里面的readme.txt或者AN1506。

               	正点原子@ALIENTEK
               	2015-4-18
		广州市星翼电子科技有限公司
                电话：020-38271790
                传真：020-36773971
	       	购买：http://shop62103354.taobao.com
                      http://shop62057469.taobao.com
                公司网站：www.alientek.com
         	技术论坛：www.openedv.com
