codeempereor/XY-Vision-Picker/01_Docs/02_开发文档/05_具身智能演进计划书.docx

具身智能演进计划书

从颜色阈值到 YOLO 检测与试错学习抓取

XY_Vision_Picker 项目

版本：v1.0 ｜ 日期：2026-09-23 ｜ 状态：开发指导

1. 背景与现状

当前 XY_Vision_Picker 系统采用“颜色阈值分割 + 固定运动流程”的视觉伺服方案，能完成指定颜色色块的自动抓取，但存在三个局限：

- 只能识别预设颜色的规则形状目标，无法识别异形物体或多类别目标；
- 运动轨迹是固定插补，不会根据物体实际姿态调整抓取角度；
- 失败后无自学习能力，每次抓取都从零开始。

本计划书规划两条演进路线：路线 A 用 YOLO 目标检测替换颜色阈值，提升感知能力；路线 B 引入强化学习让系统通过试错学习抓取策略。两路线独立推进，可分阶段实施。

2. 演进目标

表 2-1 演进目标

阶段 | 目标 | 验收标准
A1 | YOLO 检测替换 find_blobs | 识别 ≥ 5 类物体，mAP@0.5 ≥ 0.85
A2 | K210 上实时推理 | 帧率 ≥ 5 fps，延迟 < 200 ms
B1 | 仿真环境搭建 | PyBullet/Gazebo 复现 XY 滑台模型
B2 | 仿真中 RL 抓取 | 仿真成功率 ≥ 80%
B3 | Sim2Real 迁移 | 真机成功率 ≥ 60%

3. 路线 A：YOLO 目标检测

3.1 技术选型

K210 内置 KPU（神经网络加速器），支持 YOLOv2-tiny 的 kmodel 量化推理。但 K210 算力有限（0.3 TOPS），只适合小模型。

表 3-1 推理平台对比

方案 | 模型 | 帧率 | 精度 | 推荐度
K210 KPU | YOLOv2-tiny 量化 | ~5 fps | 中等 | 现阶段首选
外置 N100 工控机 | YOLOv8-nano | >30 fps | 高 | 长期方案
树莓派 5 + Hailo8L | YOLOv8-nano | ~15 fps | 高 | 折中方案

3.2 实施步骤

3.2.1 数据采集

- 用现有 K210 + OV2640 采集 500~1000 张目标物体图片（多角度、多光照）；
- 用 LabelImg 或 Labelme 标注边界框和类别；
- 数据增强：旋转、亮度、噪声、裁剪，扩充到 3000+ 张。

3.2.2 模型训练

- PC 上用 YOLOv5-nano 或 YOLOv8-nano 训练，输出 PyTorch 模型；
- 用 ONNX → NNCF 量化 → kmodel 转换工具链，转为 K210 KPU 可用的量化模型；
- 验证集 mAP@0.5 ≥ 0.85 再部署。

3.2.3 K210 部署

- MaixPy 加载 kmodel，推理输出 bounding box；
- 取目标类别置信度最高的 bbox 中心作为新的 (cx, cy)；
- 对外接口保持 $cx,cy,flag\n 格式不变，STM32 侧零修改。

3.3 风险

- K210 帧率不足 → 切外置推理板，K210 只做 IO；
- 量化后精度下降 → 量化感知训练（QAT）；
- 数据量不足 → 先用公开数据集预训练，再迁移。

4. 路线 B：试错学习抓取策略

4.1 思路

让系统在仿真环境中通过大量试错学习抓取策略（策略网络输入图像+状态，输出夹爪位置/角度），再迁移到真机。这是具身智能的核心。

4.2 技术栈

表 4-1 仿真与 RL 技术栈

组件 | 选型 | 说明
仿真器 | PyBullet | 开源，轻量，机器人建模方便
滑台建模 | URDF | CoreXY 简化为 XY 两轴平移关节
RL 算法 | PPO 或 SAC | 稀疏奖励，抓取成功即+1
视觉策略 | CNN + MLP | 输入 RGB 图像，输出 (x,y,angle,grip)
Sim2Real | 域随机化 | 仿真中随机光照/物体纹理

4.3 实施步骤

4.3.1 仿真建模

- 在 PyBullet 中建立 CoreXY 滑台模型：两个平移关节 + 夹爪；
- 工作台面放 5~10 种物体（方块、圆柱、异形）；
- 相机在正上方，渲染 RGB 图像，分辨率 64×64。

4.3.2 奖励函数

reward = 0
if 夹爪成功抬起物体并移动到投放点:
reward = +1.0 # 稀疏正奖励
elif 物体掉出工作台:
reward = -0.5
elif 夹爪未接触物体:
reward = -0.01 # 时间惩罚，鼓励快速完成

4.3.3 训练

- PPO 训练 5000~10000 episodes，单 GPU 约 12~24 小时；
- 成功率从随机 ~5% 提升到 ~80%；
- 记录训练曲线，验证收敛。

4.3.4 Sim2Real 迁移

- 域随机化：仿真中随机光照、物体颜色、摩擦系数；
- 真机部署：策略网络输出 (x,y)，STM32 执行；
- 真机 fine-tune：用真机数据微调策略网络，成功率从 ~40% 提升到 ~60%。

4.4 风险

- 仿真到真机差距大 → 域随机化 + 真机微调；
- 训练不稳定 → 从单物体开始，逐步增加复杂度；
- 真机试错危险 → 先用低速小范围试，限位保护常开。

5. 阶段计划

表 5-1 阶段计划

阶段 | 周期 | 内容 | 产出
阶段 1 | 4 周 | 路线 A：数据采集 + YOLO 训练 | K210 kmodel，5 类目标检测
阶段 2 | 2 周 | 路线 A：K210 部署 + 联调 | 替换 find_blobs，STM32 零修改
阶段 3 | 4 周 | 路线 B：PyBullet 建模 + PPO 训练 | 仿真成功率 ≥ 80%
阶段 4 | 3 周 | 路线 B：Sim2Real + 真机微调 | 真机成功率 ≥ 60%
阶段 5 | 2 周 | 整合：YOLO 感知 + RL 策略 | 端到端抓取 demo

6. 硬件升级清单

表 6-1 硬件升级清单

硬件 | 用途 | 预算
N100 工控机或树莓派 5 | YOLO 推理 + RL 策略部署 | ~500 元
Hailo8L 加速棒（可选） | 推理加速 | ~300 元
GPU（训练用） | PC 已有 / 云端租用 | 0/按需
多类目标物体套件 | 训练数据采集 | ~100 元

7. 验收标准

- YOLO 能识别 ≥ 5 类日常物体，mAP@0.5 ≥ 0.85；
- 推理延迟 < 200ms，不影响运动控制周期；
- RL 策略在仿真中成功率 ≥ 80%；
- 真机 Sim2Real 成功率 ≥ 60%；
- 系统能从未见过的新物体中抓取成功 ≥ 50%。

8. 风险与对策

表 8-1 风险清单

风险 | 后果 | 对策
K210 推理帧率不足 | 延迟大 | 切外置推理板
Sim2Real gap | 真机失败 | 域随机化 + 真机微调
训练不收敛 | 项目卡住 | 从单物体简单场景开始
真机试错损坏机械 | 硬件损坏 | 低速小范围 + 限位保护
数据量不足 | 模型泛化差 | 公开数据集预训练 + 迁移
