codeempereor/XY-Vision-Picker/06_Resources/PCAN/USB转CAN使用说明书.pdf

## PCAN 固件使用说明书

# 1 PCAN 驱动安装

## 1.1 驱动安装 解压：驱动\win\PEAK-System_Driver-Setup.zip 之后，打开 PeakOemDrv.exe

来安装驱动，

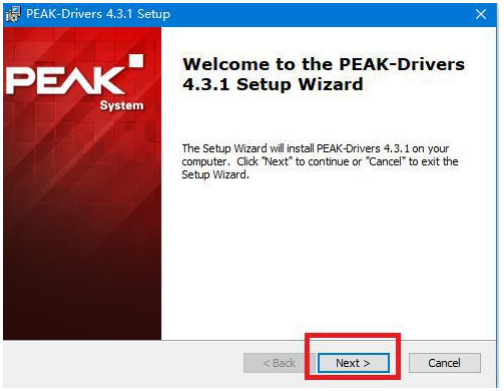
[picture p14: figure]
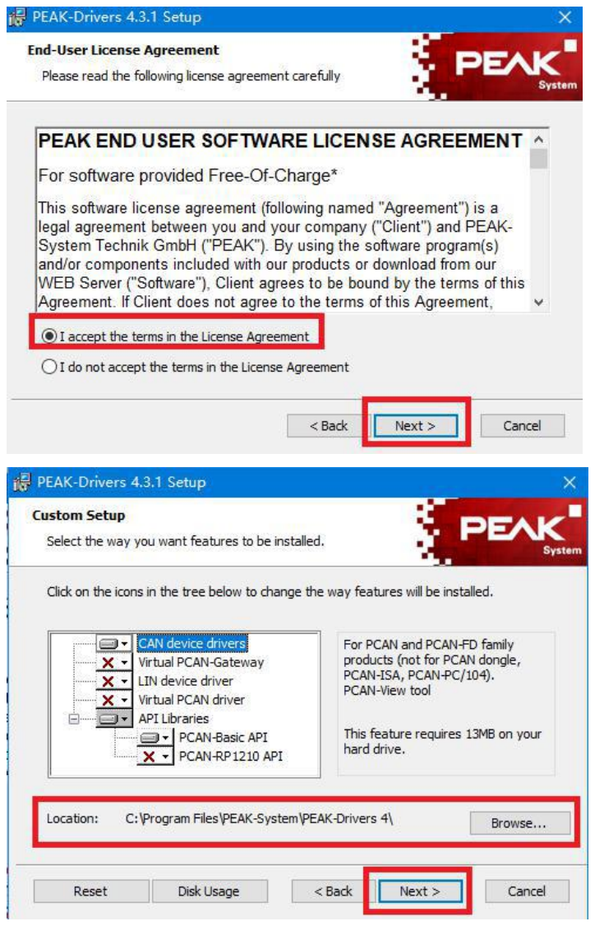
[picture p15: page 2]
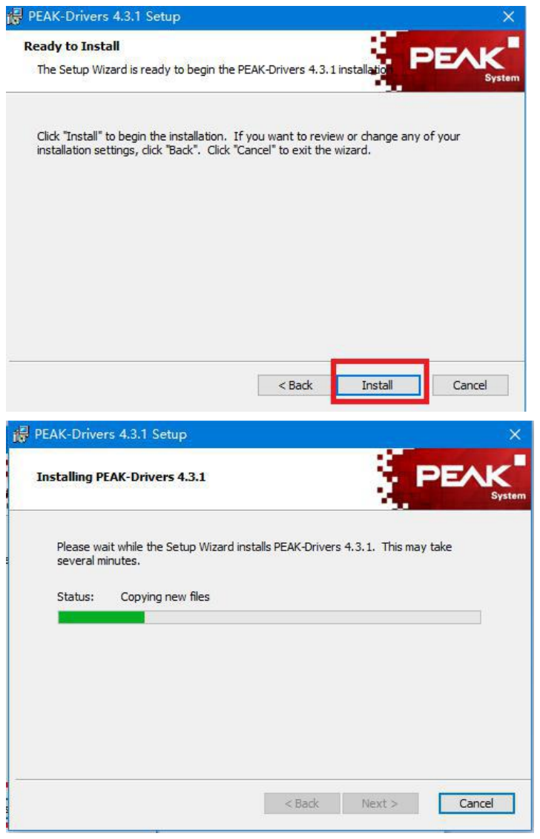
[picture p16: page 3]
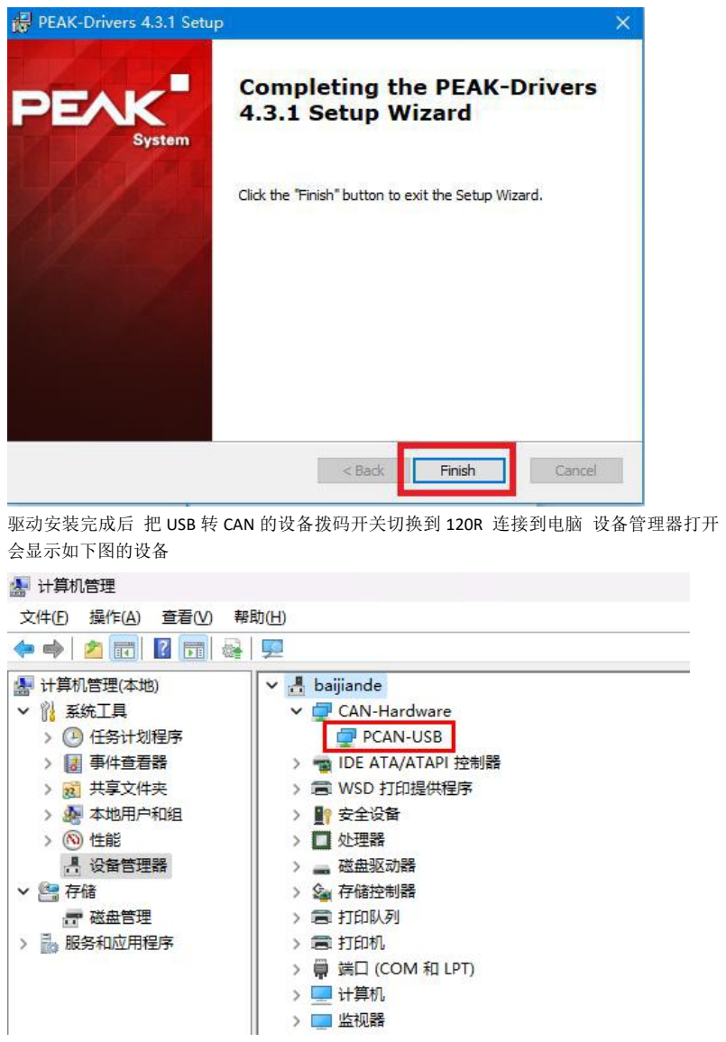
[picture p17: page 4]

驱动安装完成后 把 USB 转 CAN 的设备拨码开关切换到 120R 连接到电脑 设备管理器打开 会显示如下图的设备

## 1.2 关于设备拨码开关的说明

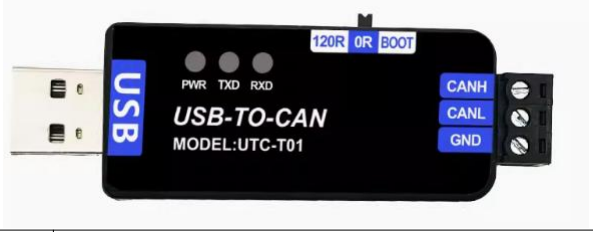
[picture p18: figure]

120R | 正常通信模式打了开 120R 终端电阻 （当二个设备通信时必需要有一个设备有接 120R 终端电阻）
0R | 正常通信模式断开 120R 终端电阻
BOOT | 用来刷固件

# 2 PCAN VIEW 上位机软件使用

2.1 解压 | 上位机/pcanview | 运行 pcanveiw.exe 选

## 好通信波特率

如下图所示

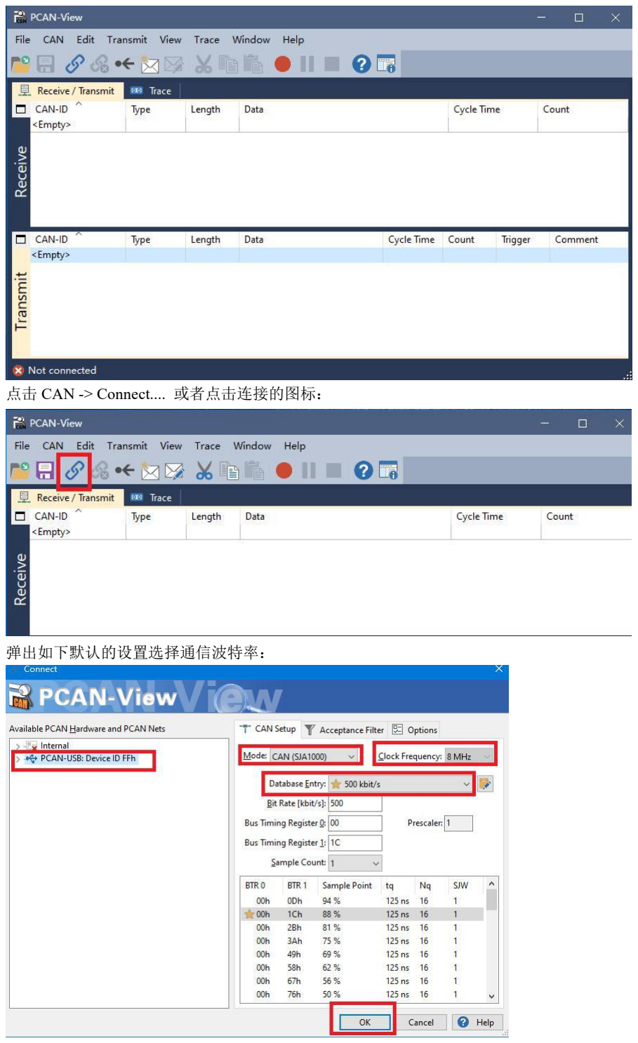
[picture p19: page 6]

点击 CAN -> Connect.... 或者点击连接的图标：

弹出如下默认的设置选择通信波特率：

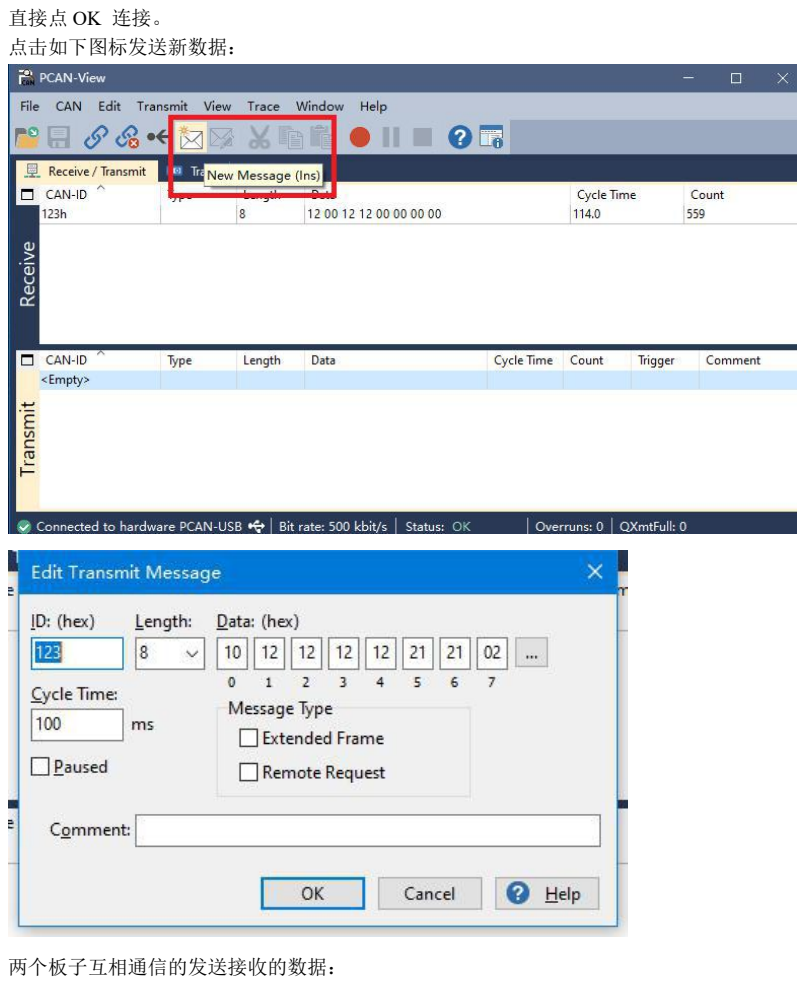
[picture p20: page 7]

直接点 OK 连接。
点击如下图标发送新数据：

两个板子互相通信的发送接收的数据：

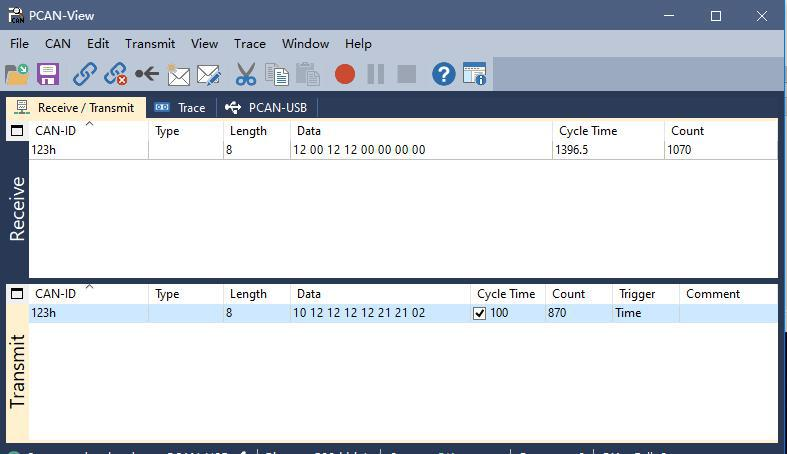
[picture p21: figure]
