codeempereor/XY-Vision-Picker/02_Hardware/05_实物照片/滑台实物图_03.jpg

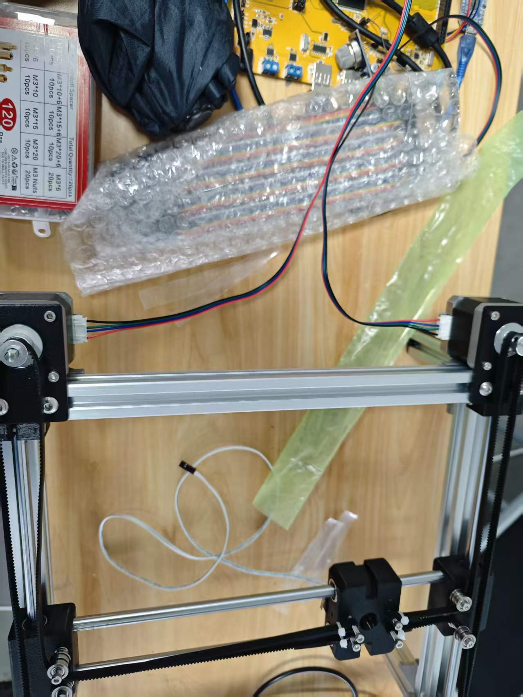
02_Hardware/05_实物照片/滑台实物图_03.jpg
