codeempereor/XY-Vision-Picker/02_Hardware/05_实物照片/联调实拍/4f85e53f2556bc6d3ffc2e7811f09578.jpg

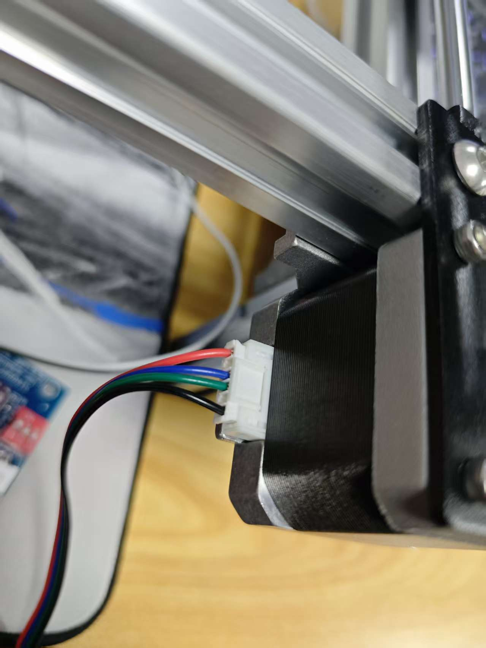
02_Hardware/05_实物照片/联调实拍/4f85e53f2556bc6d3ffc2e7811f09578.jpg
