codeempereor/XY-Vision-Picker/02_Hardware/05_实物照片/联调实拍/5ee5a03c809310c652b33d6908071570.jpg

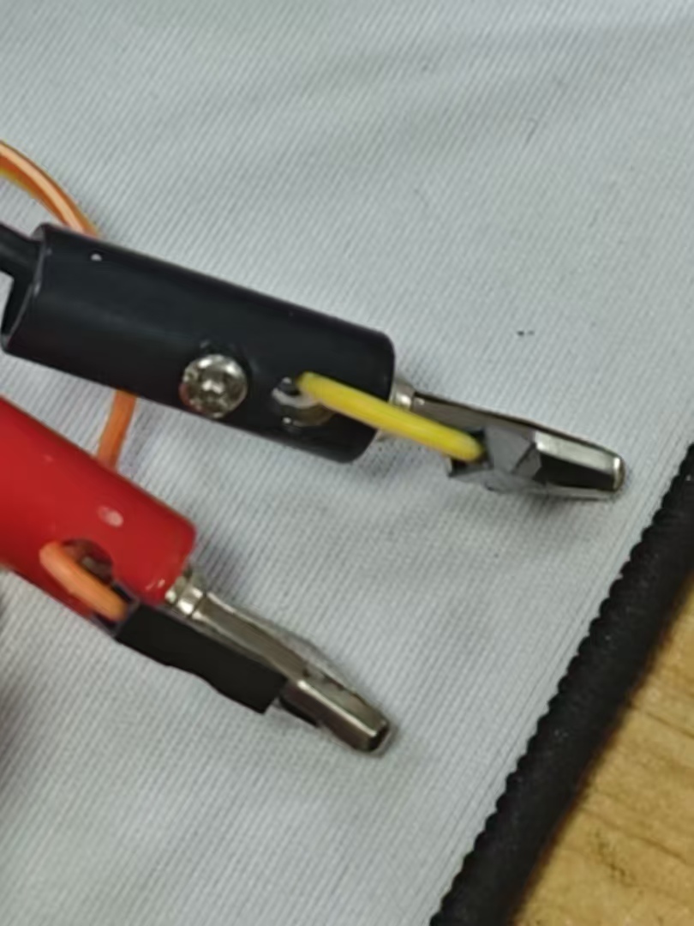
02_Hardware/05_实物照片/联调实拍/5ee5a03c809310c652b33d6908071570.jpg
