codeempereor/XY-Vision-Picker/02_Hardware/05_实物照片/联调实拍/9d236d98af57c6f9e4abf6cf74d512da.jpg

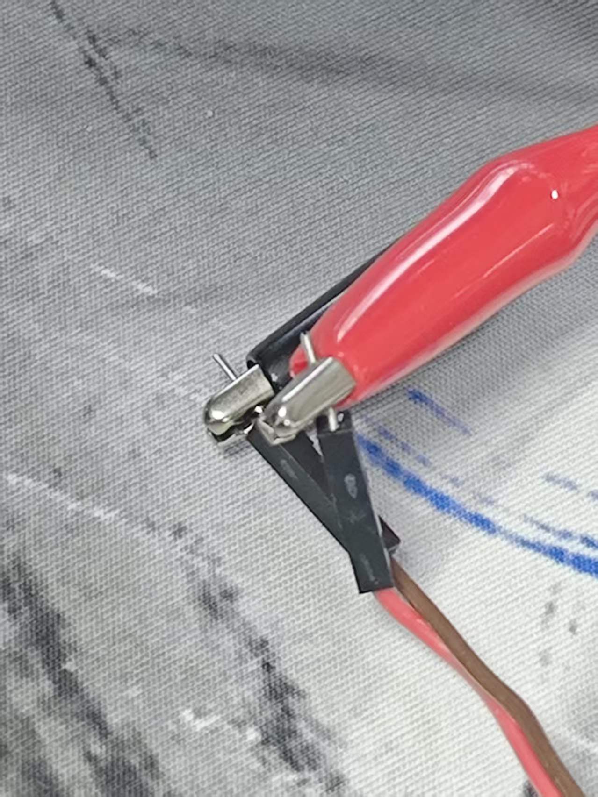
02_Hardware/05_实物照片/联调实拍/9d236d98af57c6f9e4abf6cf74d512da.jpg
