codeempereor/XY-Vision-Picker/02_Hardware/05_实物照片/联调实拍/9ff65c3057934f0ef5b61470fab4ff9e.jpg

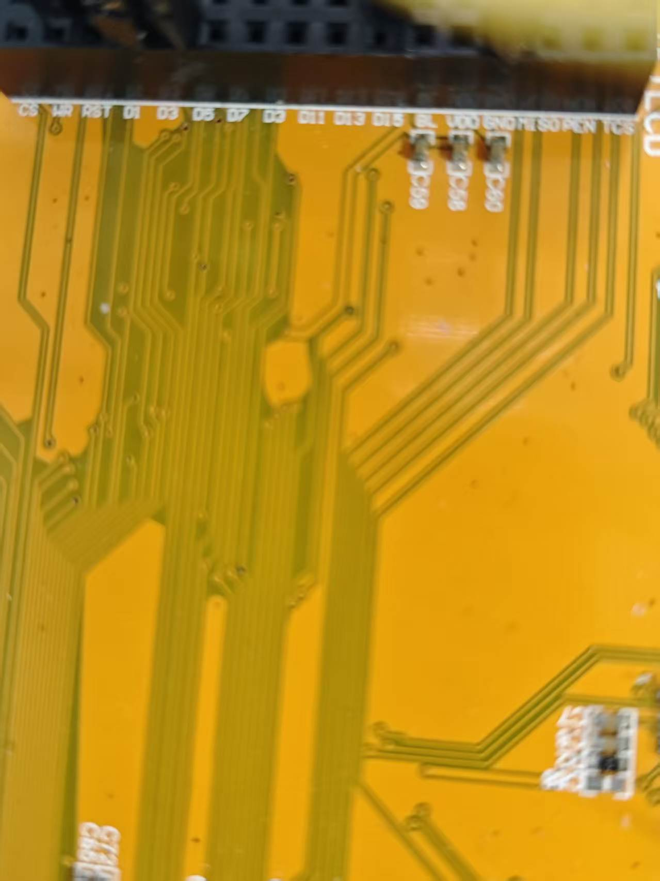
02_Hardware/05_实物照片/联调实拍/9ff65c3057934f0ef5b61470fab4ff9e.jpg
