codeempereor/XY-Vision-Picker/02_Hardware/05_实物照片/联调实拍/8132d7a928e2b81092677e888f8c6315.jpg

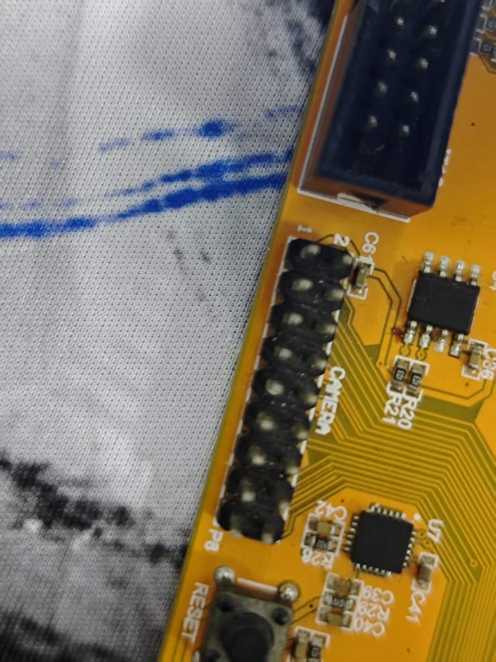
02_Hardware/05_实物照片/联调实拍/8132d7a928e2b81092677e888f8c6315.jpg
