codeempereor/XY-Vision-Picker/02_Hardware/05_实物照片/联调实拍/372500084663e44a3ac1c68c14fdcb8a.jpg

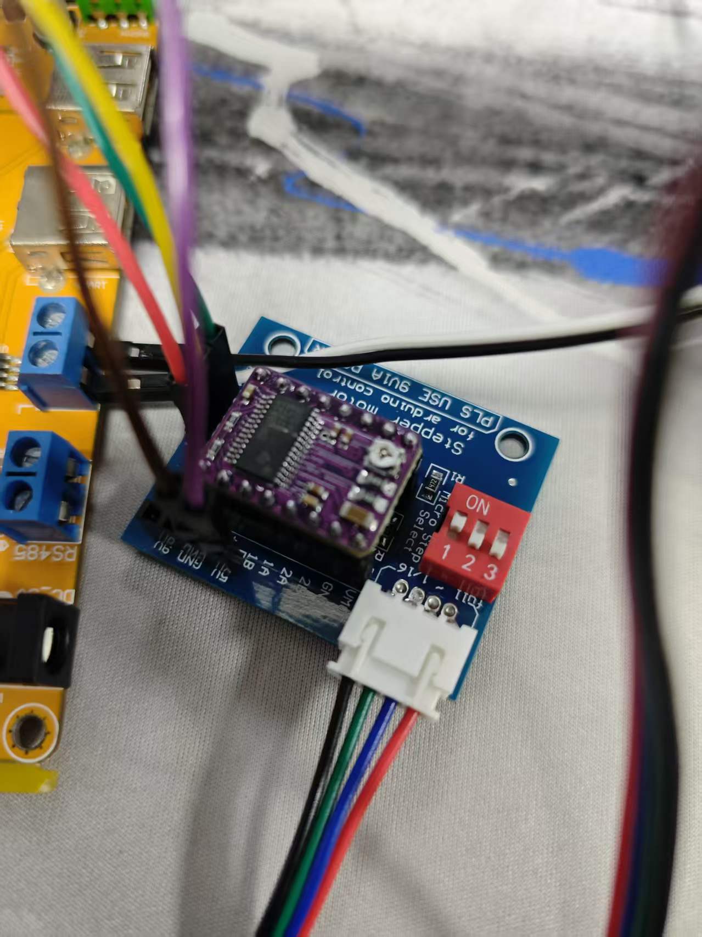
02_Hardware/05_实物照片/联调实拍/372500084663e44a3ac1c68c14fdcb8a.jpg
