codeempereor/XY-Vision-Picker/02_Hardware/05_实物照片/联调实拍/be11dff2f6a2b2637ea716daa06b990c.jpg

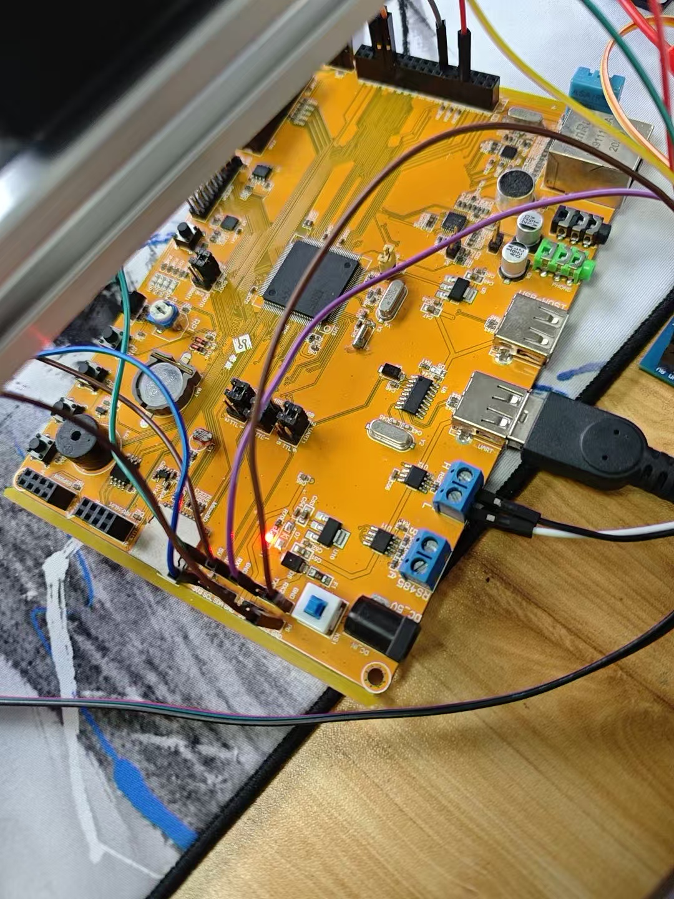
02_Hardware/05_实物照片/联调实拍/be11dff2f6a2b2637ea716daa06b990c.jpg
