codeempereor/XY-Vision-Picker/02_Hardware/05_实物照片/联调实拍/bf2fc40f390f2f189be689d30a3c6ff1.jpg

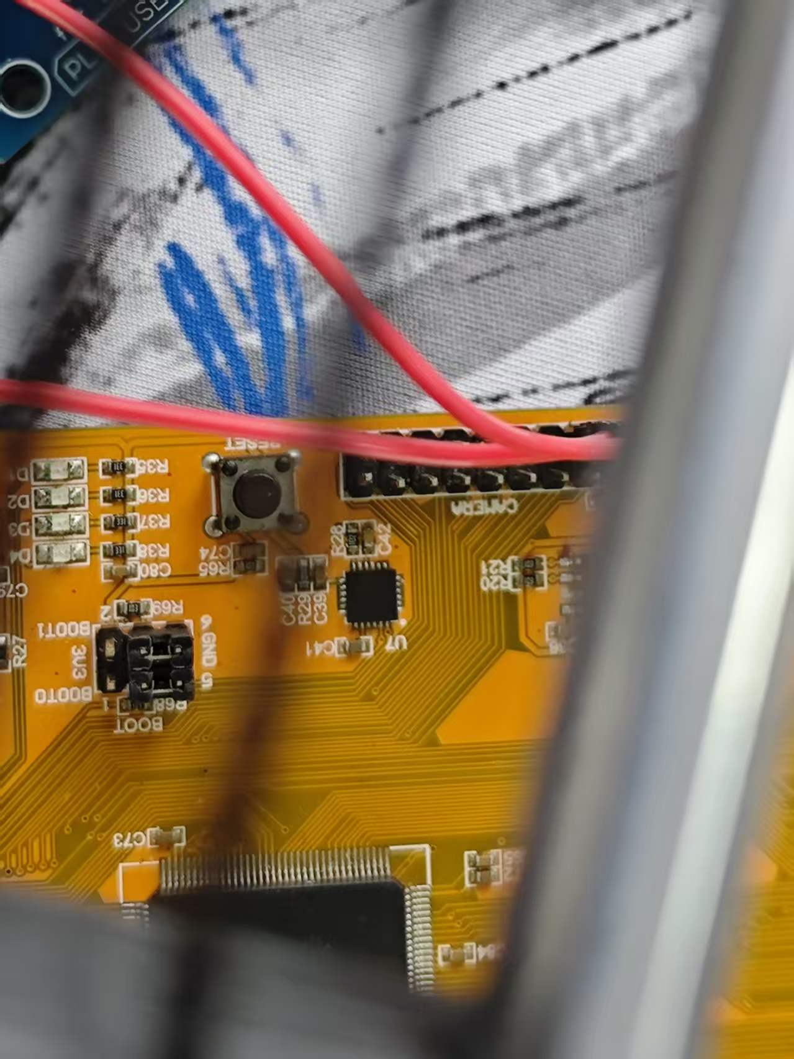
02_Hardware/05_实物照片/联调实拍/bf2fc40f390f2f189be689d30a3c6ff1.jpg
