codeempereor/XY-Vision-Picker/02_Hardware/05_实物照片/联调实拍/c57783b25e4ebea9dde11a6e59a8ded0.jpg

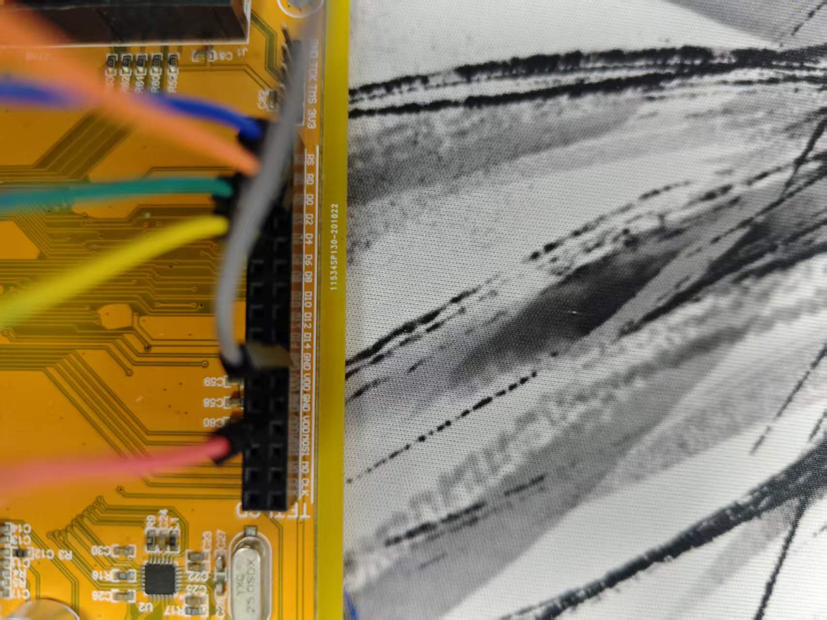
02_Hardware/05_实物照片/联调实拍/c57783b25e4ebea9dde11a6e59a8ded0.jpg
