codeempereor/XY-Vision-Picker/02_Hardware/05_实物照片/联调实拍/f3ad705743fe9e2d346967ac791b4c84.jpg

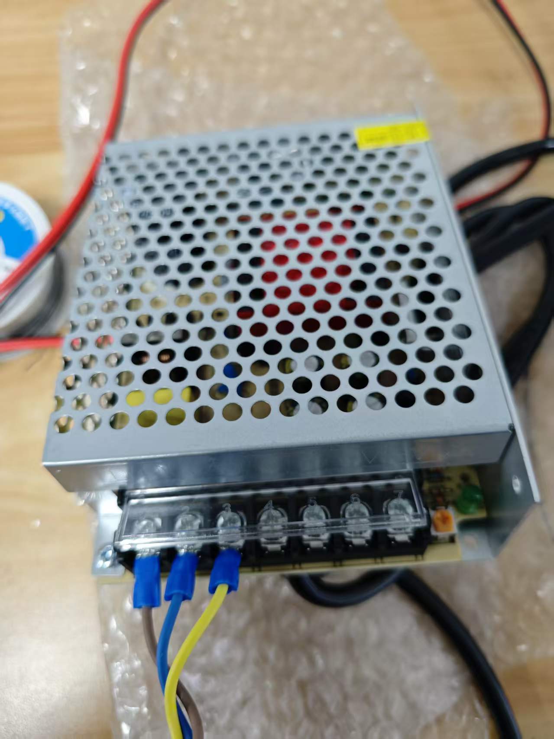
02_Hardware/05_实物照片/联调实拍/f3ad705743fe9e2d346967ac791b4c84.jpg
