codeempereor/XY-Vision-Picker/02_Hardware/05_实物照片/联调实拍/fe254f32c5297cd4d3eec34403ce01f5.jpg

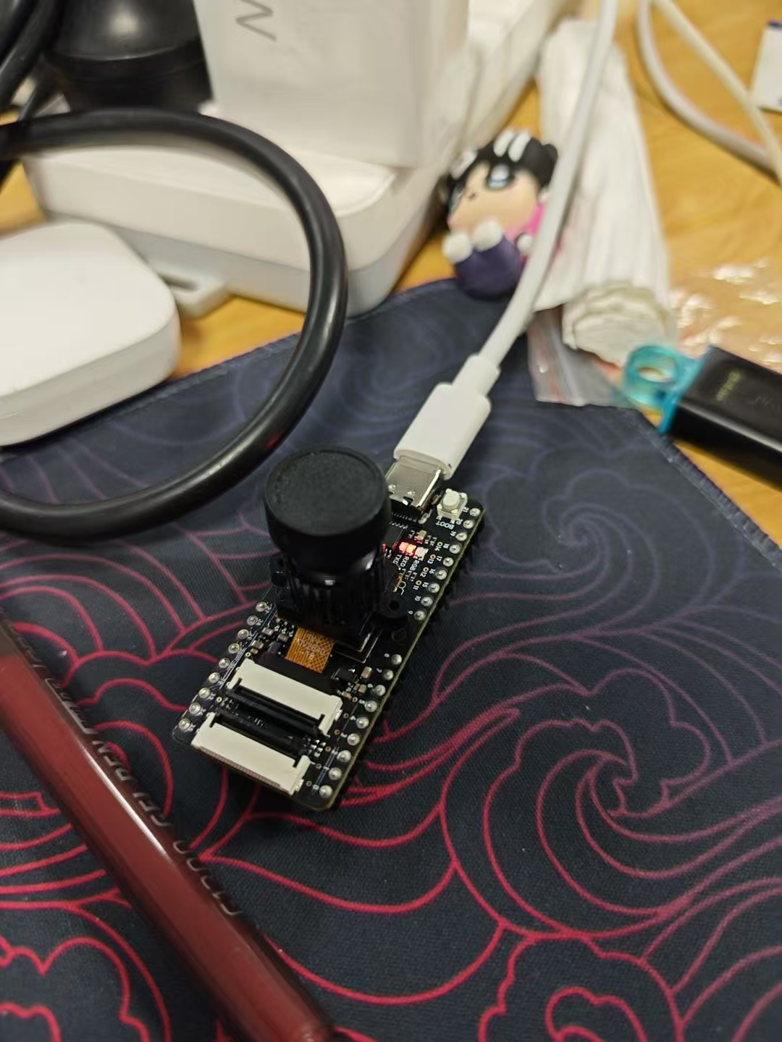
02_Hardware/05_实物照片/联调实拍/fe254f32c5297cd4d3eec34403ce01f5.jpg
