codeempereor/XY-Vision-Picker/02_Hardware/05_实物照片/联调实拍/fffad052ffe0bc86ee35dca2123d657c.jpg

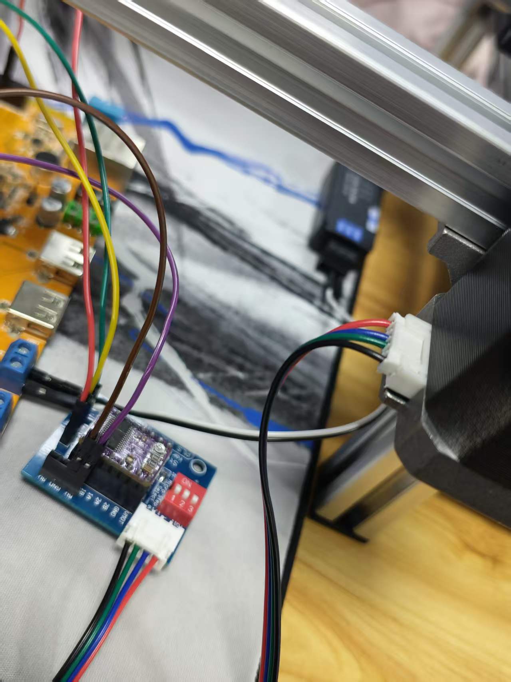
02_Hardware/05_实物照片/联调实拍/fffad052ffe0bc86ee35dca2123d657c.jpg
