codeempereor/XY-Vision-Picker/02_Hardware/05_实物照片/联调实拍/USB转CAN适配器_UTC-T01.jpg

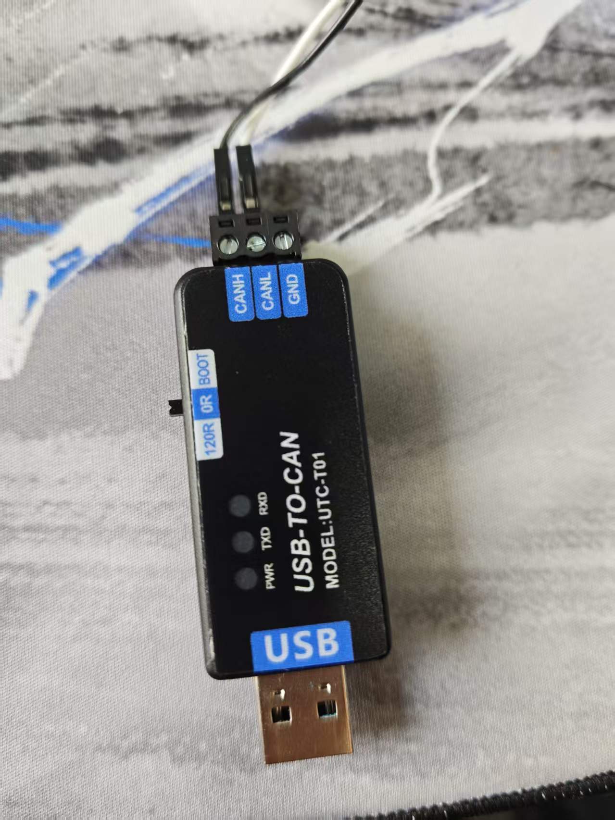
02_Hardware/05_实物照片/联调实拍/USB转CAN适配器_UTC-T01.jpg
