codeempereor/XY-Vision-Picker/02_Hardware/05_实物照片/联调实拍/步进电机_42电机与联轴器滑台.jpg

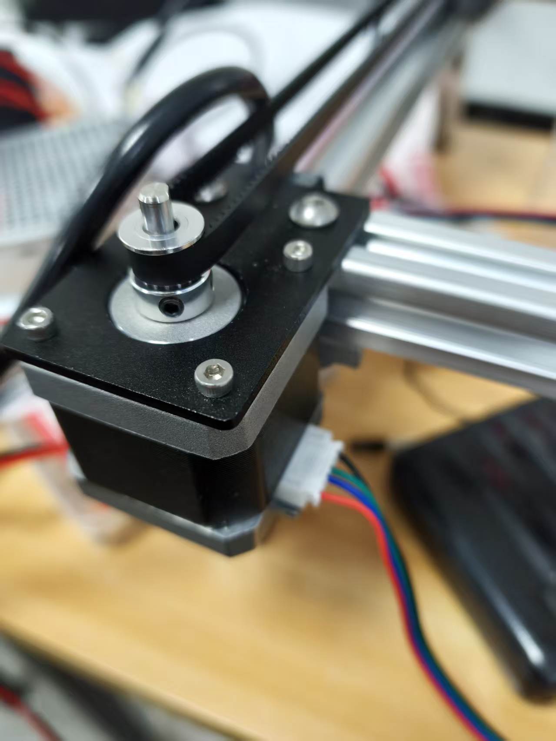
02_Hardware/05_实物照片/联调实拍/步进电机_42电机与联轴器滑台.jpg
