codeempereor/XY-Vision-Picker/02_Hardware/05_实物照片/联调实拍/电源模块_24V开关电源.jpg

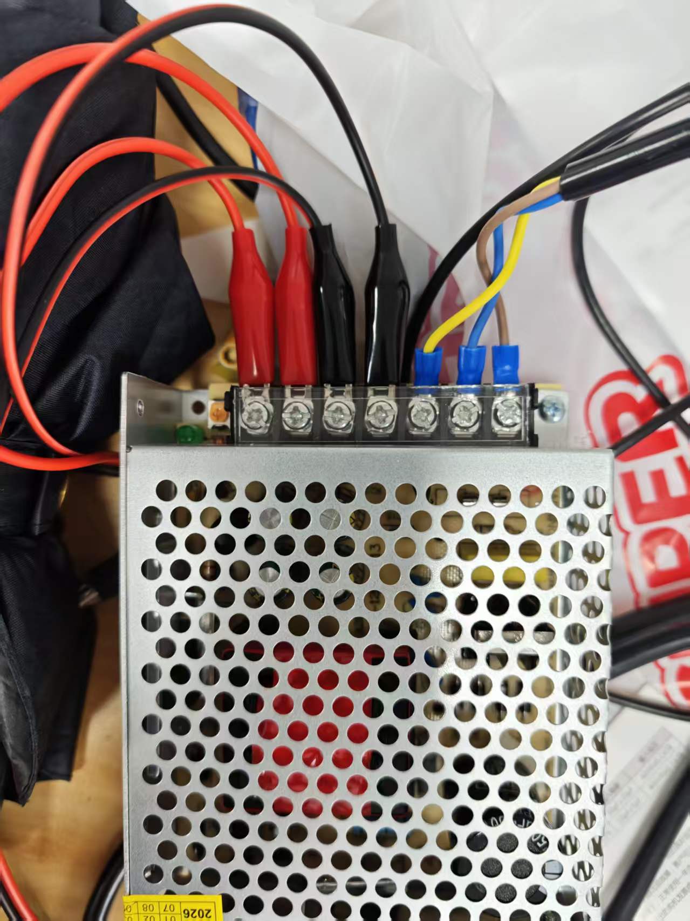
02_Hardware/05_实物照片/联调实拍/电源模块_24V开关电源.jpg
