codeempereor/XY-Vision-Picker/02_Hardware/05_实物照片/联调实拍/驱动板_HW434_A4988扩展板.jpg

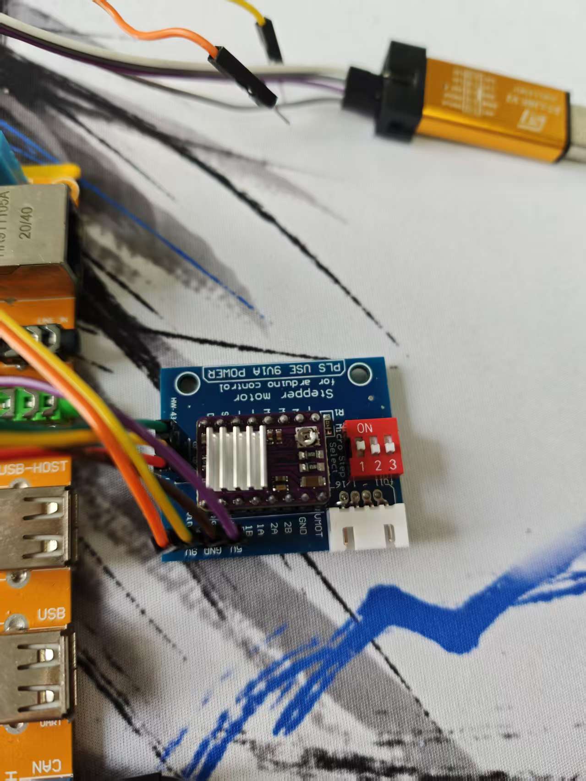
02_Hardware/05_实物照片/联调实拍/驱动板_HW434_A4988扩展板.jpg
