codeempereor/XY-Vision-Picker/06_Resources/corexy XY滑台资料/4988驱动电流调节.png

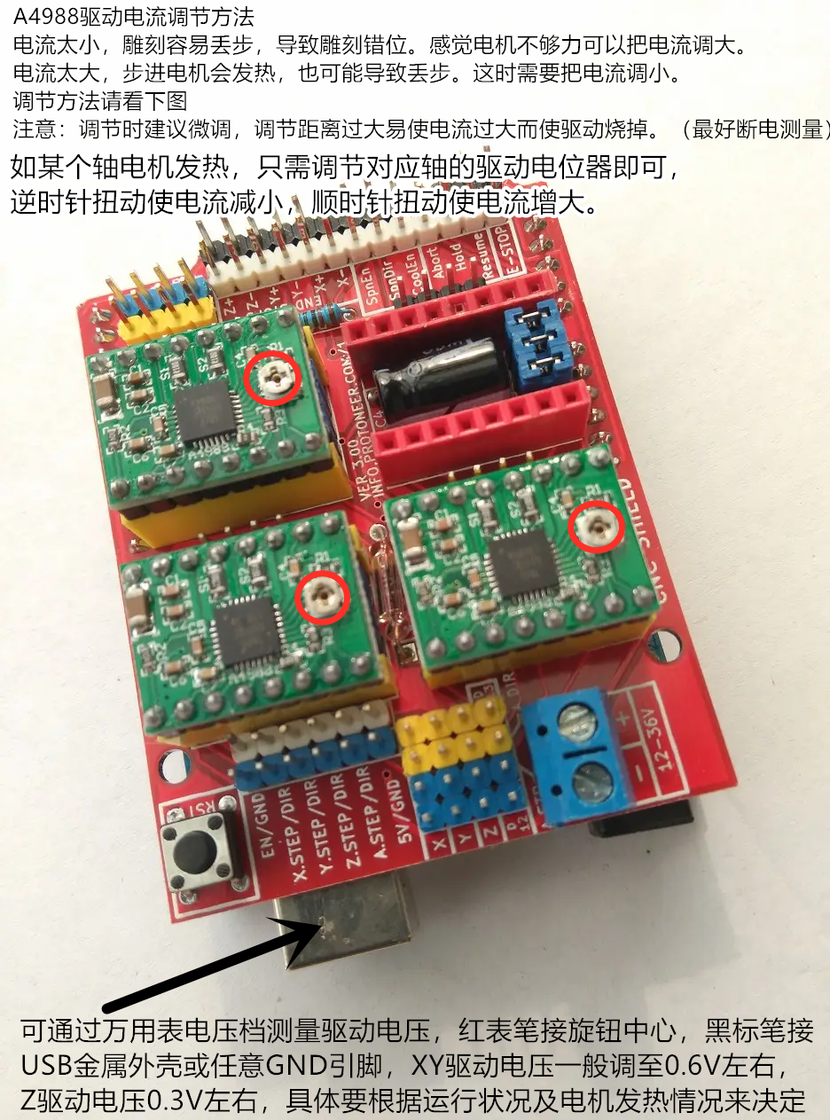
06_Resources/corexy XY滑台资料/4988驱动电流调节.png
