codeempereor/XY-Vision-Picker/06_Resources/corexy XY滑台资料/MiniLaser/ie/machinelist/images/4.jpg

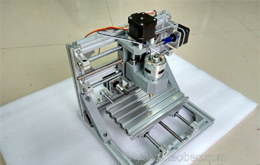
06_Resources/corexy XY滑台资料/MiniLaser/ie/machinelist/images/4.jpg
