codeempereor/XY-Vision-Picker/06_Resources/corexy XY滑台资料/MiniLaser/ie/share/error.jpg

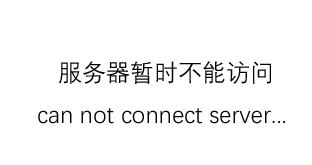
06_Resources/corexy XY滑台资料/MiniLaser/ie/share/error.jpg
