codeempereor/XY-Vision-Picker/06_Resources/corexy XY滑台资料/步骤2.框架搭建示例图/2018-04-24_122152.png

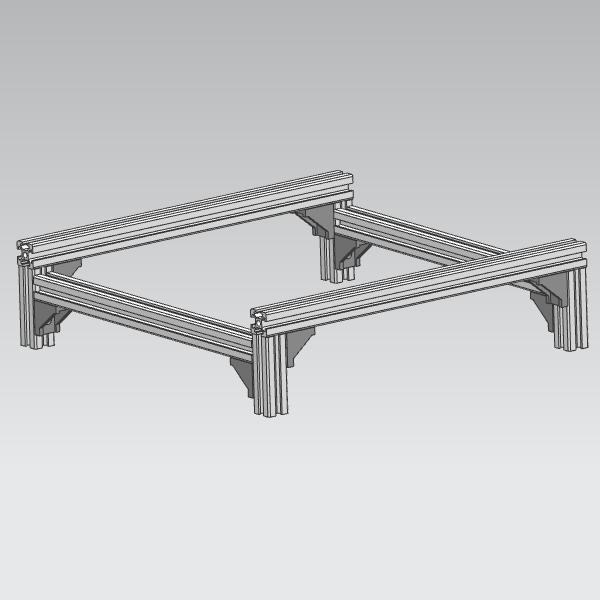
06_Resources/corexy XY滑台资料/步骤2.框架搭建示例图/2018-04-24_122152.png
