codeempereor/XY-Vision-Picker/06_Resources/PCAN/驱动/linux/测试截图.png

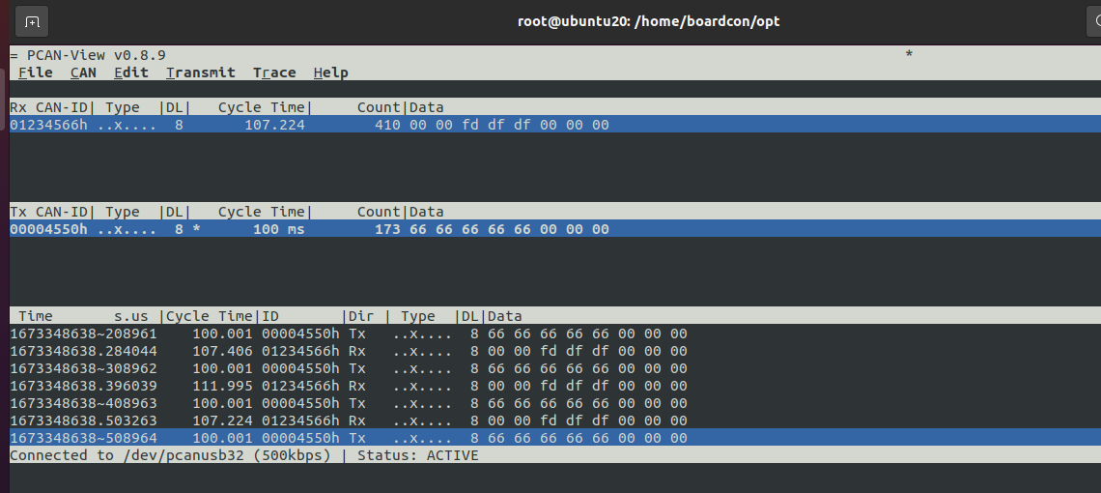
06_Resources/PCAN/驱动/linux/测试截图.png
