codeempereor/XY-Vision-Picker/06_Resources/STM32F407ZET6/07_开发板实物与标注.bmp

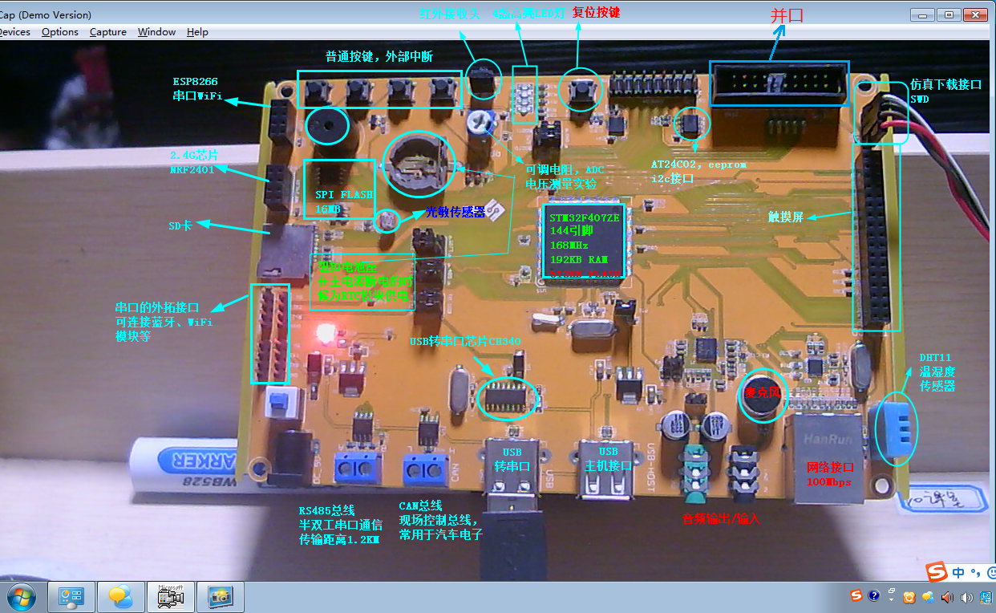
06_Resources/STM32F407ZET6/07_开发板实物与标注.bmp
