codeempereor/XY-Vision-Picker/06_Resources/STM32F407ZET6/08_JLink与开发板的连接.bmp

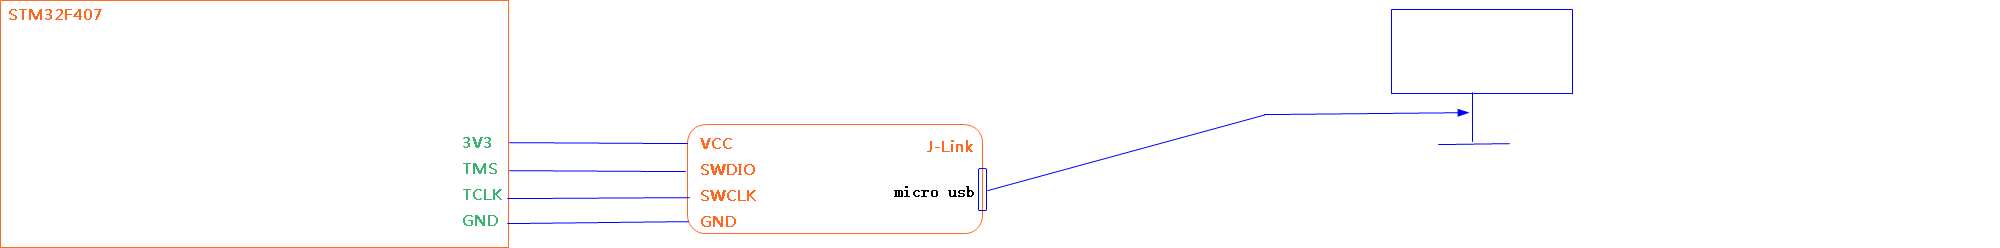
06_Resources/STM32F407ZET6/08_JLink与开发板的连接.bmp
