codeempereor/XY-Vision-Picker/02_Hardware/03_BOM清单/BOM清单.md

# BOM 清单（XY_Vision_Picker 硬件）

> 依据：根目录 `README.md` 硬件清单、`06_Resources/` 实物资料与联调开发日志整理。
> 数量/型号以实物与开发日志为准；未列采购价格与渠道（按需自行补充）。

## 主控与视觉

| 序号 | 模块 | 型号/规格 | 数量 | 备注 |
|---|---|---|---|---|
| 1 | 运动主控 | STM32F407ZET6 开发板（GEC-M4） | 1 | 板载 CAN 接口（PD0/PD1）与调试口 |
| 2 | 视觉协处理器 | K210 开发板（Maix Bit 类） | 1 | MaixPy 固件，UART 与 407 通信 |
| 3 | 摄像头 | 正点原子 ATK-OV2640 红版（YX64074） | 1 | DVP 接口飞线至 K210 |

## 运动与执行

| 序号 | 模块 | 型号/规格 | 数量 | 备注 |
|---|---|---|---|---|
| 4 | 运动平台 | CoreXY 十字滑台（X 约 200mm / Y 约 150mm） | 1 | 含同步带、滑块、框架 |
| 5 | 步进电机 | 42 步进电机（两相四线） | 2 | X/Y 轴各一 |
| 6 | 电机驱动 | A4988 模块 + HW-434 扩展板 | 2 | MS1~MS3 拨码调细分；板上电位器调电流 |
| 7 | 夹爪 | 3D 打印多指舵机夹爪 | 1 | 含 MG90S/MG996R 舵机 |

## 交互与传感

| 序号 | 模块 | 型号/规格 | 数量 | 备注 |
|---|---|---|---|---|
| 8 | 显示屏 | ST7789V SPI TFT（0.96 寸类） | 1 | 显示坐标与状态 |
| 9 | 键盘 | 4x4 矩阵键盘 | 1 | 手动模式输入 |
| 10 | 限位开关 | 卧式微动开关 | 2 | X- 接 PA4（高触发）/ Y- 接 PD6（低触发） |
| 11 | 备用传感器 | GY-31 颜色传感器 / 红外定位模块 | 按需 | 替代视觉方案的预留项 |

## 电源与通信

| 序号 | 模块 | 型号/规格 | 数量 | 备注 |
|---|---|---|---|---|
| 12 | 主电源 | 24V/5A 电源模块 | 1 | 经杜邦线接驱动板 VMOT |
| 13 | 舵机电源 | 5V/2A 独立供电 | 1 | 舵机夹爪供电（与 407 共地） |
| 14 | USB-CAN | USB 转 CAN 适配器（UTC-T01，实物） | 1 | CANH/CANL/GND 端子 + 120R 终端开关；接 407 CAN 引脚 PD0/PD1 |
| 15 | 调试下载器 | ST-Link / J-Link | 1 | Keil 烧录调试 |

> 注：README 硬件清单中"板载 TJA1050"以开发板实物为准；实际联调为 407 CAN 引脚（PD0/PD1）直接接 UTC-T01 适配器 CANH/CANL（共地），详见 `04_接线图/README.md` 与开发文档。
