codeempereor/XY-Vision-Picker/06_Resources/corexy XY滑台资料/X滑块部分模型/X滑块部分模型/X滑块.stp

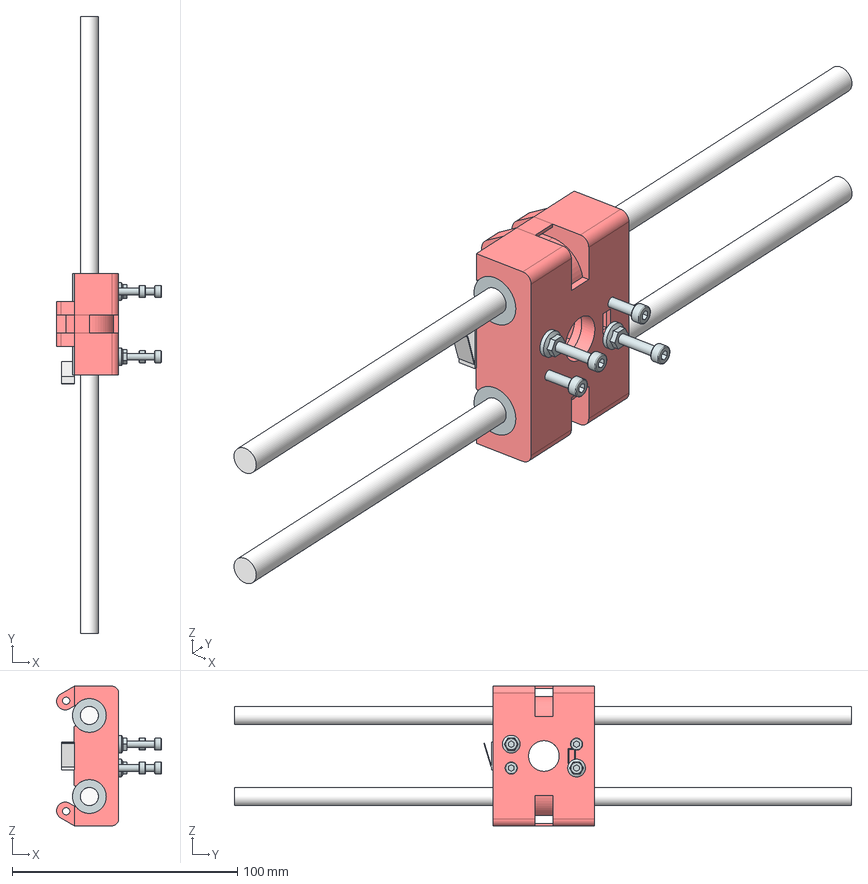
[picture p73: CAD file, 2026-10-14]
06_Resources/corexy XY滑台资料/X滑块部分模型/X滑块部分模型/X滑块.stp
46.6 x 274.0 x 62.0 mm
