codeempereor/XY-Vision-Picker/(list of files, cad)

Other CAD files:
06_Resources/corexy XY滑台资料/X滑块部分模型/X滑块部分模型/X滑块.prt
