codeempereor/XY-Vision-Picker/05_Test/单元测试/README.md

# 单元测试

当前单元测试以无硬件仿真为主：`../test_three_in_one.py` 覆盖协议解析/运动决策/CAN 编码/上位机显示的纯逻辑单元。

实机模块级验证（电机脉冲-位移标定、限位触发、CAN 收帧）记录在 `01_Docs/02_开发日志/` 与 `02_开发文档/` 中，后续可在此目录补充逐模块测试脚本。
