codeempereor/XY-Vision-Picker/05_Test/联调记录/README.md

# 联调记录

实机联调过程、现象与修复结论见 `01_Docs/02_开发日志/`（6 份，按日期编号）：

- 电机只响不动/失步 → 电源供电与电流调节排查
- 电源模块指示灯闪烁 → 驱动板逐块上电定位
- 电位器损坏导致电机不受控 → 更换驱动板
- 上位机点移动无反应 → CAN 引脚/适配器接线与帧协议核对
- CAN 收帧不增 → 波特率/引脚配置修复
- 限位开关单只 → PA4 高触发 / PD6 低触发接线确认

硬件接线最终结论见 `01_Docs/02_开发文档/10_硬件接线指南.docx`；实物照片见 `02_Hardware/05_实物照片/联调实拍/`。
