codeempereor/XY-Vision-Picker/03_Firmware/STM32/MDK-ARM/build_log.txt

*** Using Compiler 'V6.24', folder: 'F:\MDK5\ARM\ARMCLANG\Bin'
Rebuild target 'CoreXY_Motion'
compiling stm32f4xx_it.c...
compiling main.c...
compiling profile.c...
compiling interp.c...
compiling corexy.c...
compiling key.c...
compiling motion.c...
compiling limit.c...
compiling system_stm32f4xx.c...
compiling servo.c...
compiling comm_uart.c...
compiling stepper.c...
compiling comm_can.c...
compiling stm32f4xx_hal.c...
compiling stm32f4xx_hal_rcc.c...
compiling stm32f4xx_hal_rcc_ex.c...
compiling stm32f4xx_hal_gpio.c...
compiling stm32f4xx_hal_can.c...
compiling stm32f4xx_hal_uart.c...
compiling stm32f4xx_hal_cortex.c...
compiling stm32f4xx_hal_tim_ex.c...
compiling stm32f4xx_hal_pwr.c...
compiling stm32f4xx_hal_pwr_ex.c...
compiling stm32f4xx_hal_tim.c...
compiling stm32f4xx_hal_flash.c...
../Drivers/STM32F4xx_HAL_Driver/Src/stm32f4xx_hal_flash_ex.c(948): warning: unused parameter 'Banks' [-Wunused-parameter]
  948 | static void FLASH_MassErase(uint8_t VoltageRange, uint32_t Banks)
      |                                                            ^
../Drivers/STM32F4xx_HAL_Driver/Src/stm32f4xx_hal_flash_ex.c(1027): warning: unused parameter 'Banks' [-Wunused-parameter]
 1027 | static HAL_StatusTypeDef FLASH_OB_EnableWRP(uint32_t WRPSector, uint32_t Banks)
      |                                                                          ^
../Drivers/STM32F4xx_HAL_Driver/Src/stm32f4xx_hal_flash_ex.c(1063): warning: unused parameter 'Banks' [-Wunused-parameter]
 1063 | static HAL_StatusTypeDef FLASH_OB_DisableWRP(uint32_t WRPSector, uint32_t Banks)
      |                                                                           ^
3 warnings generated.
compiling stm32f4xx_hal_flash_ex.c...
compiling stm32f4xx_hal_dma.c...
compiling stm32f4xx_hal_dma_ex.c...
compiling queue.c...
assembling startup_stm32f407xx.s...
compiling tasks.c...
compiling list.c...
compiling timers.c...
compiling event_groups.c...
compiling croutine.c...
compiling port.c...
compiling stream_buffer.c...
compiling heap_4.c...
linking...
Program Size: Code=40526 RO-data=614 RW-data=48 ZI-data=27496  
FromELF: creating hex file...
".\CoreXY_Motion.axf" - 0 Error(s), 3 Warning(s).
Build Time Elapsed:  00:00:05
