codeempereor/XY-Vision-Picker/01_Docs/02_开发日志/开发日志03_Keil 编译适配与运动控制模块集成.docx

# 第3期开发日志——Keil 编译适配与运动控制模块集成

XY_Vision_Picker 项目开发日志

表1 日志基本信息

项目 | 内容
项目名称 | XY_Vision_Picker（基于 STM32F407 的两轴 X-Y 视觉识别抓取系统）
记录日期 | 2026-10-09 至 2026-10-10
所属阶段 | 三期：固件落地
本期状态 | 编译 0 错误 0 警告，hex 已生成

# 一、本期目标

用本机 Keil MDK5 将 STM32 工程完整编译，产出可烧录文件。

运动控制模块（CoreXY 反解、直线插补、加减速、限位回零）集成落位。

# 二、工作内容

## 2.1 工程配置

Keil 5.43.1 加 AC6 编译器（armclang V6.24）；器件包 STM32F4xx_DFP 2.14.0；Target 使用 FPU2 单精度浮点、512KB Flash 与 128KB RAM；分散加载文件 CoreXY_Motion.sct；源码组含 Core、App 十个模块、HAL 十五个源文件、FreeRTOS 内核与 ARM_CM4F 移植文件、启动文件。

## 2.2 编译错误修正

累计修正八类编译问题，错误数由 483 收敛至 0，详见本期问题表。

## 2.3 运动控制实现

CoreXY 反解：两电机步数差按 dm1 等于 dx 加 dy、dm2 等于 dx 减 dy 计算；Bresenham 直线插补按长轴主轴整数逼近保证两轴同步到位；梯形加减速用整数实现，按满加速步数 vmax 平方除以二倍加速度判定三角或梯形；TIM6 节拍按速度动态修改重载值；双限位硬回零分两阶段，X 先走 22000 步找 X 负向开关、Y 后走 17000 步找 Y 负向开关；限位中断立即停定时器并置急停标志。

# 三、问题与解决

表2 本期问题处理记录

序号 | 问题现象 | 根因 | 处理 | 状态
1 | 类型未定义报错 483 处 | 手写 hal_conf.h 缺模块头包含链 | 补全模块头 Includes 段（rcc/gpio/dma/cortex/can/tim/uart/pwr/flash 等） | 已解决
2 | 队列与信号量类型未定义 | motion.h 未包含 FreeRTOS 头 | 加入 FreeRTOS.h、queue.h、semphr.h | 已解决
3 | 定时器辅助函数隐式声明 | CubeMX 私有函数在 HAL 头无声明 | main.c 顶部增加前置声明 | 已解决
4 | 未启用硬件浮点 | AC6 未传浮点编译选项 | 编译加 -mfloat-abi=hard -mfpu=fpv4-sp-d16 | 已解决
5 | 流缓冲区文件编译失败 | 内核 V11 需要当前任务句柄宏为 1 | FreeRTOSConfig 相关宏置 1 | 已解决
6 | 汇编与 C 对象 ABI 冲突 | 软浮点与硬浮点属性不兼容 | 汇编加 FPv4-SP，Target 改用 FPU2 | 已解决
7 | 故障钩子未定义 | 配置启用钩子但无实现 | main.c 实现栈溢出与内存分配失败钩子 | 已解决
8 | 格式化警告 | sscanf 格式与整型指针不匹配 | 改按 %d 匹配 int32 型 | 已解决

# 四、验证与结果

编译结果 0 Error 0 Warning；代码约 50KB、RAM 约 28KB，资源余量充足。

产物 CoreXY_Motion.axf 与 CoreXY_Motion.hex 生成于 MDK-ARM 目录；复现命令为 UV4.exe 加工程文件批处理参数。

# 五、遗留问题与下期计划

遗留：脉冲与位移的实测标定待硬件接线后执行。

下期：K210 视觉模块开发与工具链部署。
