codeempereor/XY-Vision-Picker/01_Docs/02_开发日志/开发日志04_K210 视觉模块开发.docx

# 第4期开发日志——K210 视觉模块开发

XY_Vision_Picker 项目开发日志

表1 日志基本信息

项目 | 内容
项目名称 | XY_Vision_Picker（基于 STM32F407 的两轴 X-Y 视觉识别抓取系统）
记录日期 | 2026-10-10
所属阶段 | 四期：视觉开发
本期状态 | 兼容性核查完成，代码交付，待硬件联调

# 一、本期目标

确认 K210 与 OV2640 的兼容性及接口硬约束。

开发红色目标识别与坐标帧输出代码，协议与 STM32 对齐。

打通 IDE 与免 IDE 两条运行路径。

# 二、工作内容

## 2.1 兼容性核查

K210 数据手册确认 D0 至 D7 数据线为芯片专用球位，只从 24P FPC 摄像头座引出，排针不可用，因此放弃排针飞线方案；控制线 SDA、SCL、RST、VSYNC、PWDN、HREF、XCLK、PCLK 在 MaixPy 固件默认映射 IO40 至 IO47（4.7K 上拉）。ATK-OV2640 红版为 2 乘 9 排针接口，需经 FPC 转接。推荐方案为 FPC 直连、代码零引脚配置，PWDN 必须拉低。

## 2.2 串口通道

K210 使用 UART1，IO6 为发射、IO7 为接收；IO4、IO5 为板载 CH552 串口桥占用不可复用。与 STM32 交叉接线：K210 发射接 STM32 PB11 接收，K210 接收接 STM32 PB10 发射，共地。

## 2.3 视觉代码实现

main.py：RGB565 格式、QVGA 分辨率、跳帧等待自动曝光收敛、开启自动增益与白平衡；红色阈值在 MaixPy 阈值编辑器对实物标定；find_blobs 加像素与面积下限并合并相近色块，取面积最大色块输出质心，按 20Hz 节流发送“$cx,cy,flag\n”；无目标时发送全零保活帧。calibrate.py 打印目标 LAB 均值辅助标定；test_uart.py 做回环测试。

# 三、问题与解决

表2 本期问题处理记录

序号 | 问题现象 | 根因 | 处理 | 状态
1 | MaixPy IDE 下载需人工验证码 | 官方下载站对大于 10MB 文件强制验证流程 | 改用官方分享页、网盘与海外分流，保存至 E 盘 | 已解决
2 | 板载固件版本过旧 | IDE 要求固件不低于 0.3.1 | 用 kflash_gui 刷写最新 MaixPy 固件 | 已解决
3 | 数据线无排针引出 | 排针飞线方案对 D0 至 D7 不成立 | 改 FPC 直连，控制线走默认引脚 | 已修正
4 | 传感器初始化失败风险 | 摄像头引脚被强制重复注册导致复位失败 | 禁止对 DVP 引脚重复注册，UART1 选 IO6、IO7 | 已规避

# 四、验证与结果

代码交付于 03_Firmware\K210_Visual\（main.py、test_uart.py、calibrate.py、README）。

输出帧协议与 STM32 comm_uart.c 解析逻辑对齐（帧头与两个逗号分隔字段）。

免 IDE 部署路径可行：main.py 放入 FAT32 格式 SD 卡根目录上电自动运行。

# 五、遗留问题与下期计划

遗留：FPC 转接的硬件联调与串口实帧验证；仿射标定参数待机械安装后更新。

下期：硬件接线与上电排障，随后进行上位机联调。
