codeempereor/XY-Vision-Picker/04_Tools/调试工具/README.md

# 调试工具

| 工具 | 用途 | 位置 |
|---|---|---|
| PEAK-System Driver Setup v500 | PEAK PCAN 设备驱动安装包（备用） | 本目录 `PEAK-System_Driver-Setup-v500\`（161MB，未入库，本地归档） |
| pcanview / TSMaster | CAN 总线监视工具 | `06_Resources/PCAN/上位机软件/` |
| USB 转 CAN 适配器（UTC-T01） | 实物适配器，无需独立驱动时按产品说明书安装 | 说明书见 `06_Resources/PCAN/USB转CAN使用说明书.pdf` |

> 说明：实际联调使用 USB 转 CAN 适配器 UTC-T01（照片见 `02_Hardware/05_实物照片/联调实拍/USB转CAN适配器_UTC-T01.jpg`）；PEAK 驱动为同用途备用方案，未在联调中使用。
