codeempereor/XY-Vision-Picker/02_Hardware/05_实物照片/联调实拍/ST-Link_V2调试器.jpg

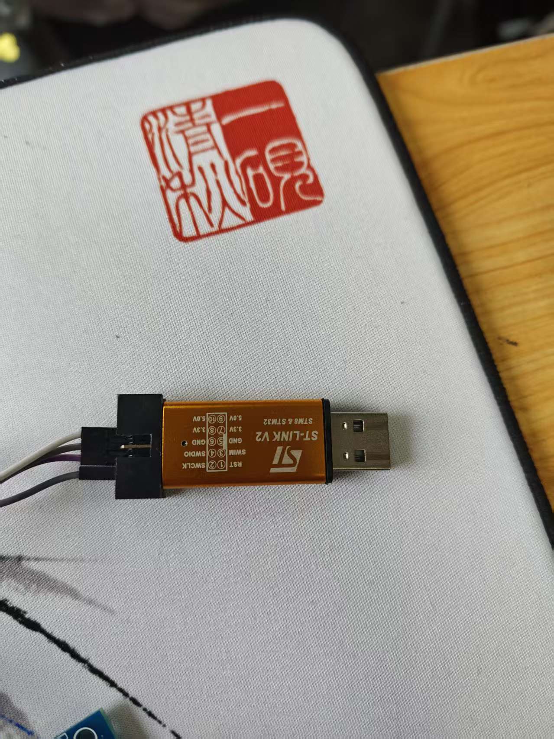
02_Hardware/05_实物照片/联调实拍/ST-Link_V2调试器.jpg
