codeempereor/XY-Vision-Picker/06_Resources/PCAN/原理图（参考）/SCH  USB To CAN V11 原理图 20231210.pdf

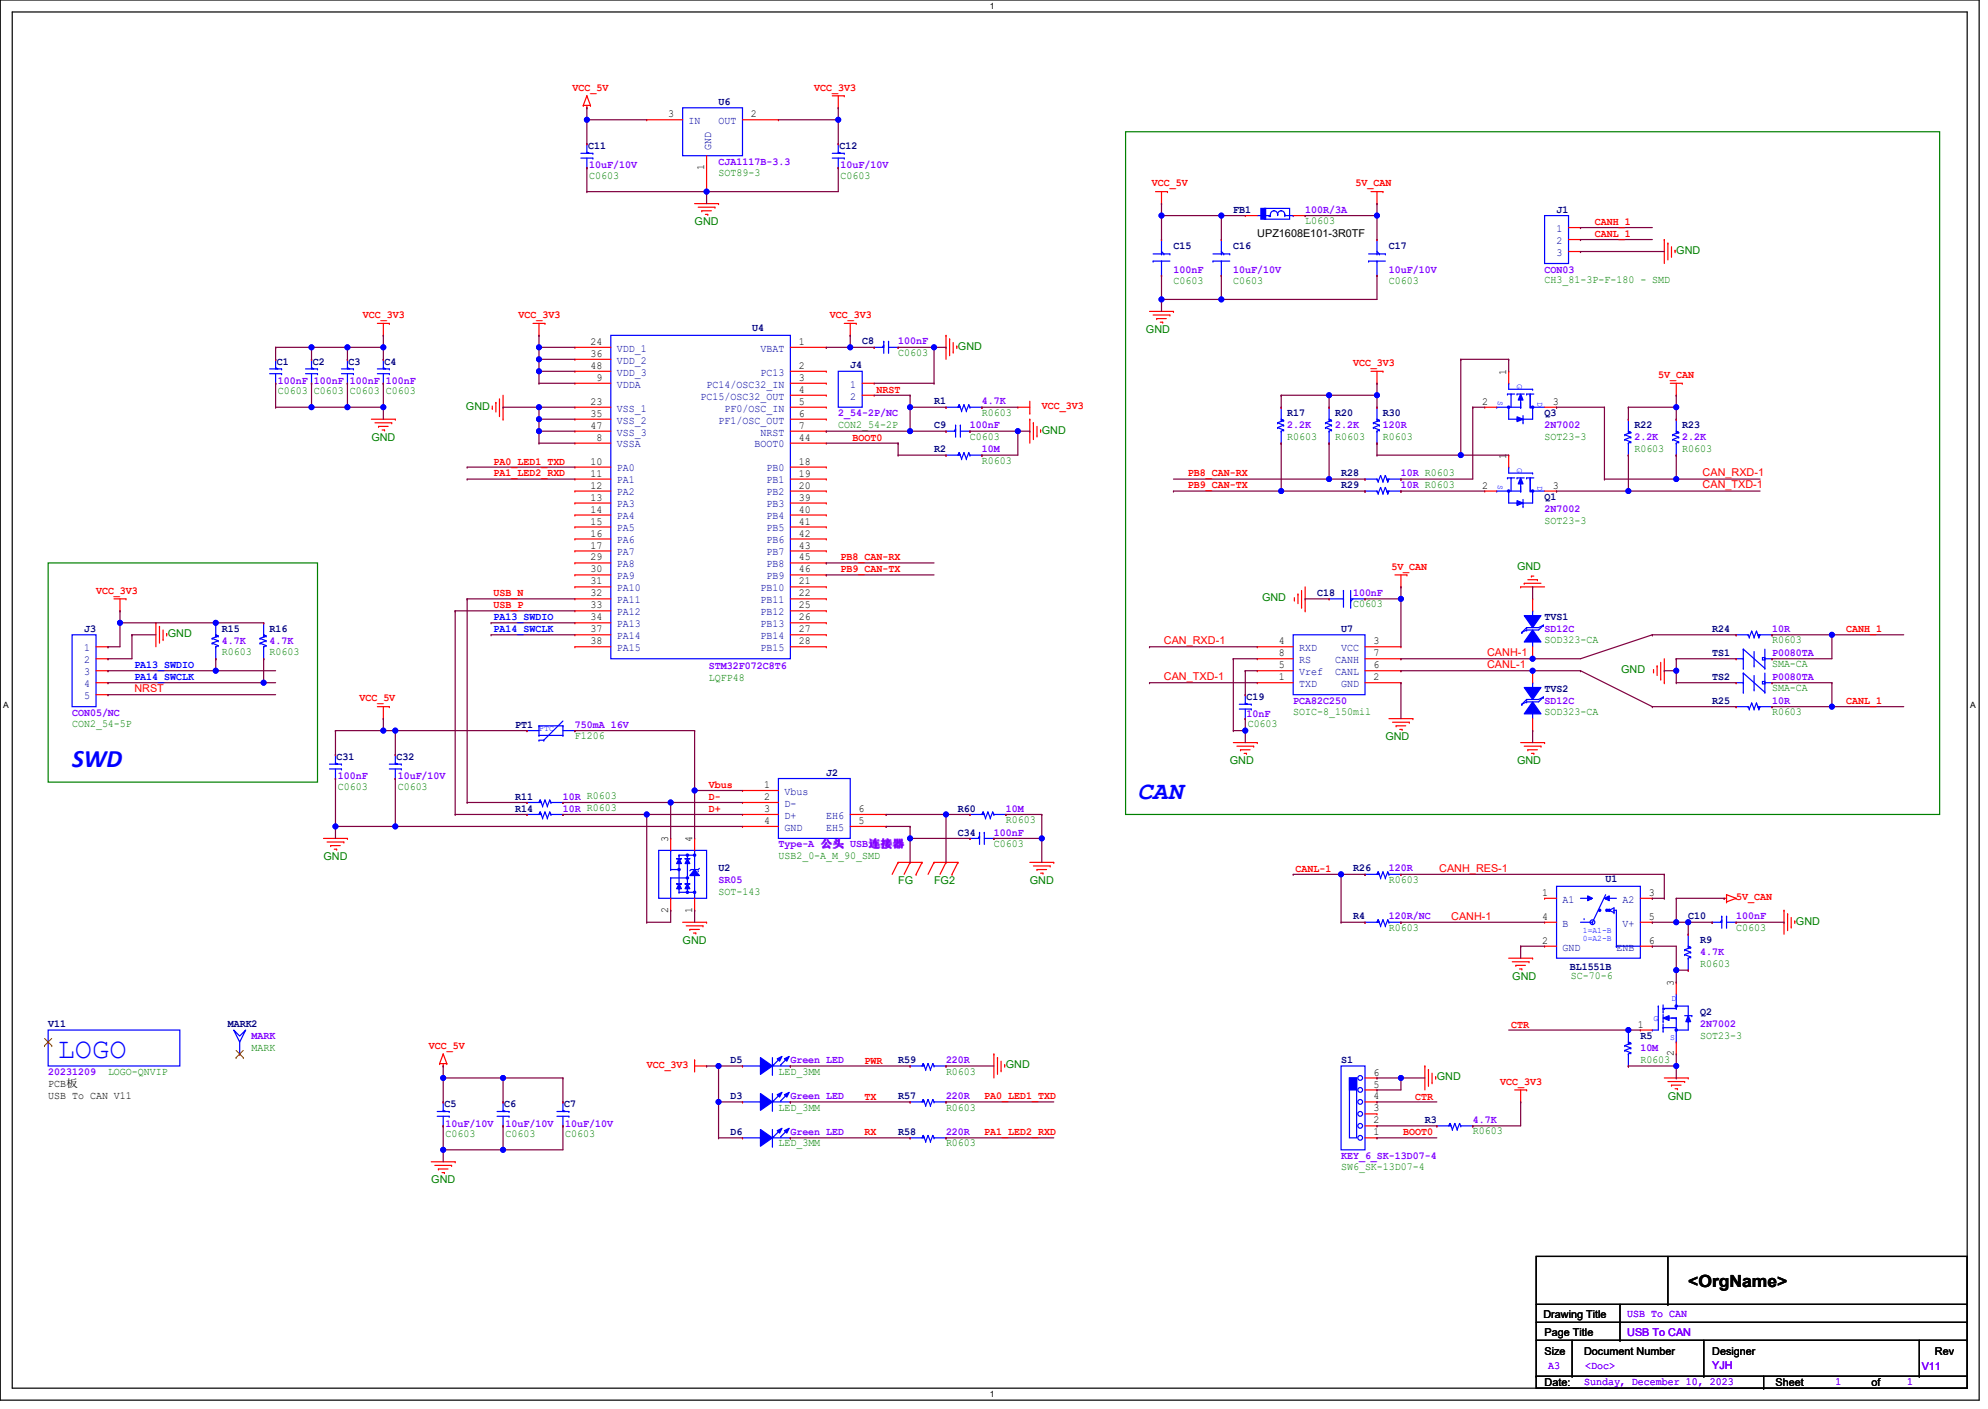
[picture p75: page 1]
