codeempereor/XY-Vision-Picker/(commit log)

2026-10-14 Initial import: STM32F407 + K210 XY vision picking system
    - Firmware: STM32F407 (GEC-M4) + FreeRTOS CoreXY motion control (Keil MDK)
    - Vision: K210 + OV2640 MaixPy color recognition (UART to STM32)
    - HMI: Qt CAN host (mypro00001), protocol 0x181/0x281/0x381
    - Docs: scheme/development/logs/QA/hardware wiring
    - Hardware: schematics, BOM, wiring diagrams, photos
    - Test: three-in-one protocol simulation
2026-10-14 chore: remove build artifacts, backups, logs and intermediate files; keep only clean source projects
    - Keil: remove .o/.d/.axf/.hex/.map/.lnp/.dep/logs/uvguix, keep .uvprojx/.uvoptx/RTE
    - Qt: remove build/build_hmi/build_qt6/debug/release/.qtcreator/Makefile/.qmake.stash/.pro.user
    - Remove STM32 backup dir and packed project zip
    - Remove ppt_work intermediate workspace (video kept locally in 01_Docs/04_演示材料, untracked)
    - Dedup oversized archives in 06_Resources
